twhunq/Butterfly-RC/design/drawings/rod_cut_list.md

# Danh sách cắt que carbon — mỗi cánh (nhân 2 cho cả bướm)

| Que | Vật liệu | Dài thiết kế (mm) | **Chiều dài cắt (mm)** | Tấm | Gắn vào | Góc với que gốc |
|---|---|---|---|---|---|---|
| LE | ống carbon 2.0×1.0 | 319.4 | **316.4** | trước | hub gốc cánh (gốc R) | — |
| Fold | que carbon đặc Ø1.0 | 280.7 | **277.7** | trước | hub gốc cánh (gốc R) | — |
| Root | que carbon đặc Ø1.0 | 253.2 | **250.2** | sau | hub gốc cánh (gốc R) | — |
| VeinA | que carbon đặc Ø1.0 | 257.5 | **255.5** | trước | khớp A trên que LE, cách R 70 mm | 34° |
| VeinB | que carbon đặc Ø0.8 | 210.4 | **208.4** | trước | khớp B trên que LE, cách R 170 mm | 17° |
| VeinC | que carbon đặc Ø0.8 | 271.5 | **270.0** | sau | khớp C trên que Fold, cách R 70 mm | 30° |
| VeinD | que carbon đặc Ø0.8 | 181.5 | **180.0** | sau | khớp D trên que Fold, cách R 170 mm | 23° |

- Chiều dài cắt = dài thiết kế trừ phần nằm trong lỗ khớp (hub gốc cánh: lỗ bắt đầu cách R 3 mm; khớp gân: cách mặt que gốc 1 mm).
- Màng mỗi bên: 844 cm² (tấm trước 470, tấm sau 374) + mép bọc 6 mm quanh que cạnh trước và que gốc.
- Gấp: phần sau gập xuống 6.62° quanh que gấp R–N → cánh sau cúi 5.0°, rủ thêm 4.3°.
- Xương sống: ống carbon tròn 3 × 2 mm, dài 154 mm (1 cây).
