twhunq/Butterfly-RC/design/drawings/wing_template_A2.pdf

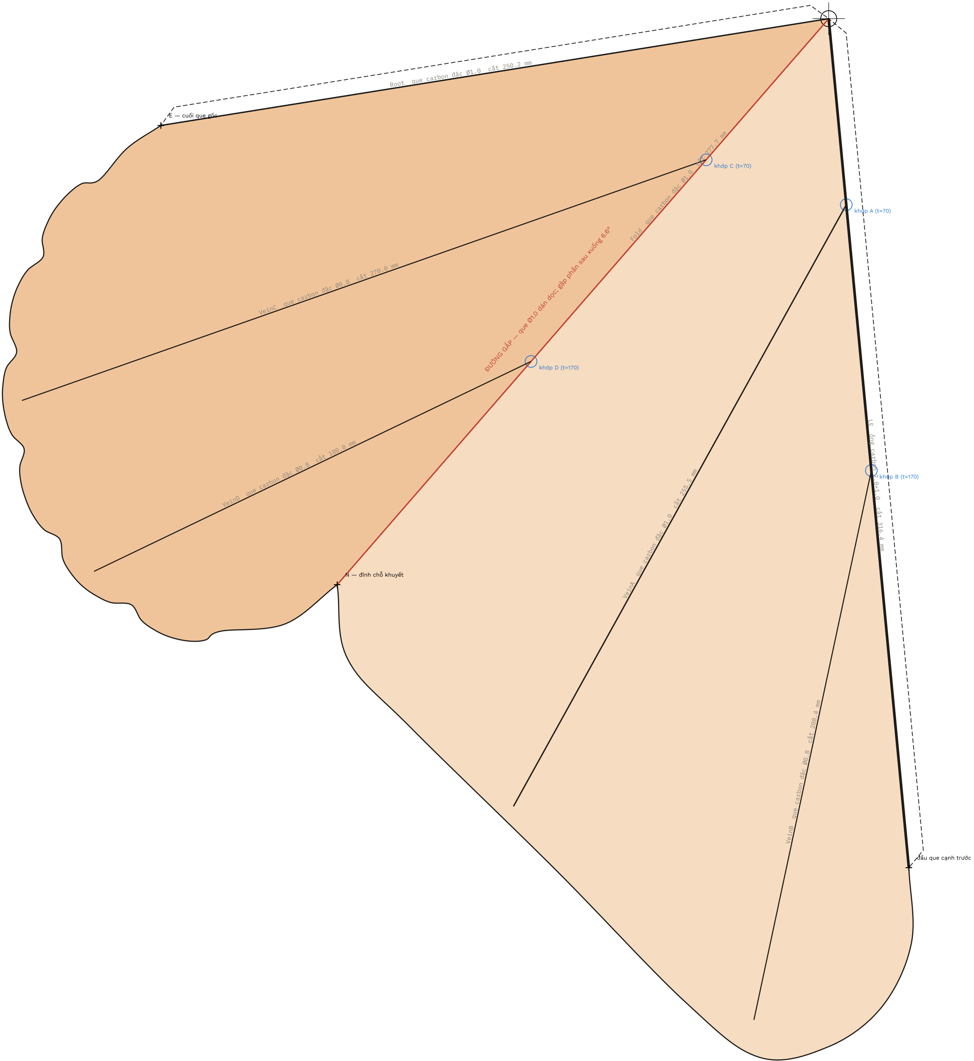
[picture p1: figure]
ĐƯỜNG GẤP; LE ống carbon 2.0×1.0 cắt 316.4 mm; Fold que carbon đặc Ø1.0 cắt 277.7 mm; Root que carbon đặc Ø1.0 cắt 250.2 mm; VeinA que carbon; đặc Ø1.0 cắt 255.5 mm; khớp A (t=70); VeinB que carbon; đặc Ø0.8 cắt 208.4 mm; khớp B (t=170); VeinC que carbon đặc Ø0.8 cắt 270.0 mm; khớp C (t=70); VeinD que carbon đặc Ø0.8 cắt 180.0 mm; khớp D (t=170); đầu que cạnh trước; N — đỉnh chỗ khuyết; E — cuối que gốc

## — que Ø1.0 dán dọc; gập phần sau xuống 6.6°

R — gốc cánh / tâm khớp nối tay servo

# CÁNH PHẢI — nhìn từ trên, mép trước bên phải, tỉ lệ 1:1

Thước kiểm tra: phải đo đúng 100 mm (và ô vuông 50 × 50 mm)

50 × 50 mm

### CẮT QUE CARBON (mỗi cánh; nhân 2 cho cả bướm)

Que | Vật liệu | Dài thiết kế | CHIỀU DÀI CẮT | Tấm | Gắn vào | Góc
LE | ống carbon 2.0×1.0 | 319.4 mm | 316.4 mm | trước | hub gốc cánh (gốc R) | —
Fold | que carbon đặc Ø1.0 | 280.7 mm | 277.7 mm | trước | hub gốc cánh (gốc R) | —
Root | que carbon đặc Ø1.0 | 253.2 mm | 250.2 mm | sau | hub gốc cánh (gốc R) | —
VeinA | que carbon đặc Ø1.0 | 257.5 mm | 255.5 mm | trước | khớp A trên que LE, cách R 70 mm | 34°
VeinB | que carbon đặc Ø0.8 | 210.4 mm | 208.4 mm | trước | khớp B trên que LE, cách R 170 mm | 17°
VeinC | que carbon đặc Ø0.8 | 271.5 mm | 270.0 mm | sau | khớp C trên que Fold, cách R 70 mm | 30°
VeinD | que carbon đặc Ø0.8 | 181.5 mm | 180.0 mm | sau | khớp D trên que Fold, cách R 170 mm | 23°

MÀNG: 1 tấm liền mỗi bên, 844 cm² (tấm trước 470 + tấm sau 374); chừa mép bọc 6 mm (nét đứt) quanh que cạnh trước và que gốc.

GẤP: dán que gấp Ø1.0 dọc đường gấp R–N; phần sau gập xuống 6.6° → cánh sau cúi 5°, rủ thêm 4.3°. Không dán que dọc mép sau (để màng tự xoắn).

Góc nhị diện 11° do khớp nối tay servo tạo sẵn. Dán màng hơi chùng; keo 3M Super 77 (mylar) hoặc B7000 (vải).

Kiểm tra trước khi cắt: thước 100 mm và ô 50 mm phải đúng kích thước sau khi in.

# BƯỚM RC · 2 SERVO · v3.1 — MẪU CẮT CÁNH

tỉ lệ 1 : 1 · in 100 % / Actual size

nguồn: butterfly_params.json · wing_geometry.py

tờ 1 / 2

2026-10-08 · mm

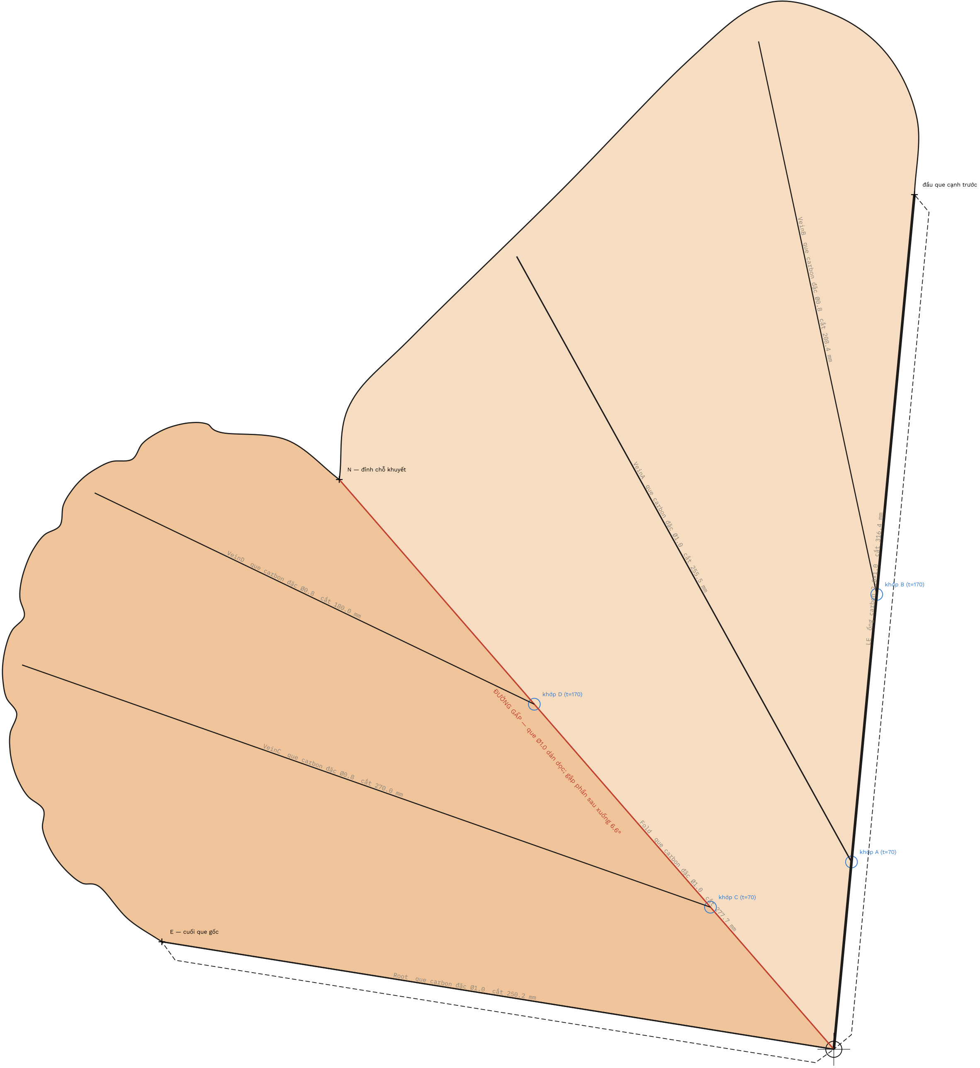
[picture p2: figure]
ĐƯỜNG GẤP; LE ống carbon 2.0×1.0 cắt 316.4 mm; Fold que carbon đặc Ø1.0 cắt 277.7 mm; Root que carbon đặc Ø1.0 cắt 250.2 mm; VeinA que carbon; đặc Ø1.0 cắt 255.5 mm; khớp A (t=70); VeinB que carbon; đặc Ø0.8 cắt 208.4 mm; khớp B (t=170); VeinC que carbon đặc Ø0.8 cắt 270.0 mm; khớp C (t=70); VeinD que carbon đặc Ø0.8 cắt 180.0 mm; khớp D (t=170); đầu que cạnh trước; N — đỉnh chỗ khuyết; E — cuối que gốc

## — que Ø1.0 dán dọc; gập phần sau xuống 6.6°

R — gốc cánh / tâm khớp nối tay servo

# CÁNH TRÁI — nhìn từ trên, mép trước bên phải, tỉ lệ 1:1

Thước kiểm tra: phải đo đúng 100 mm (và ô vuông 50 × 50 mm)

50 × 50 mm

### CẮT QUE CARBON (mỗi cánh; nhân 2 cho cả bướm)

Que | Vật liệu | Dài thiết kế | CHIỀU DÀI CẮT | Tấm | Gắn vào | Góc
LE | ống carbon 2.0×1.0 | 319.4 mm | 316.4 mm | trước | hub gốc cánh (gốc R) | —
Fold | que carbon đặc Ø1.0 | 280.7 mm | 277.7 mm | trước | hub gốc cánh (gốc R) | —
Root | que carbon đặc Ø1.0 | 253.2 mm | 250.2 mm | sau | hub gốc cánh (gốc R) | —
VeinA | que carbon đặc Ø1.0 | 257.5 mm | 255.5 mm | trước | khớp A trên que LE, cách R 70 mm | 34°
VeinB | que carbon đặc Ø0.8 | 210.4 mm | 208.4 mm | trước | khớp B trên que LE, cách R 170 mm | 17°
VeinC | que carbon đặc Ø0.8 | 271.5 mm | 270.0 mm | sau | khớp C trên que Fold, cách R 70 mm | 30°
VeinD | que carbon đặc Ø0.8 | 181.5 mm | 180.0 mm | sau | khớp D trên que Fold, cách R 170 mm | 23°

MÀNG: 1 tấm liền mỗi bên, 844 cm² (tấm trước 470 + tấm sau 374); chừa mép bọc 6 mm (nét đứt) quanh que cạnh trước và que gốc.

GẤP: dán que gấp Ø1.0 dọc đường gấp R–N; phần sau gập xuống 6.6° → cánh sau cúi 5°, rủ thêm 4.3°. Không dán que dọc mép sau (để màng tự xoắn).

Góc nhị diện 11° do khớp nối tay servo tạo sẵn. Dán màng hơi chùng; keo 3M Super 77 (mylar) hoặc B7000 (vải).

Kiểm tra trước khi cắt: thước 100 mm và ô 50 mm phải đúng kích thước sau khi in.

# BƯỚM RC · 2 SERVO · v3.1 — MẪU CẮT CÁNH

tỉ lệ 1 : 1 · in 100 % / Actual size

nguồn: butterfly_params.json · wing_geometry.py

tờ 2 / 2

2026-10-08 · mm
