twhunq/Butterfly-RC/design/drawings/butterfly_cover.png

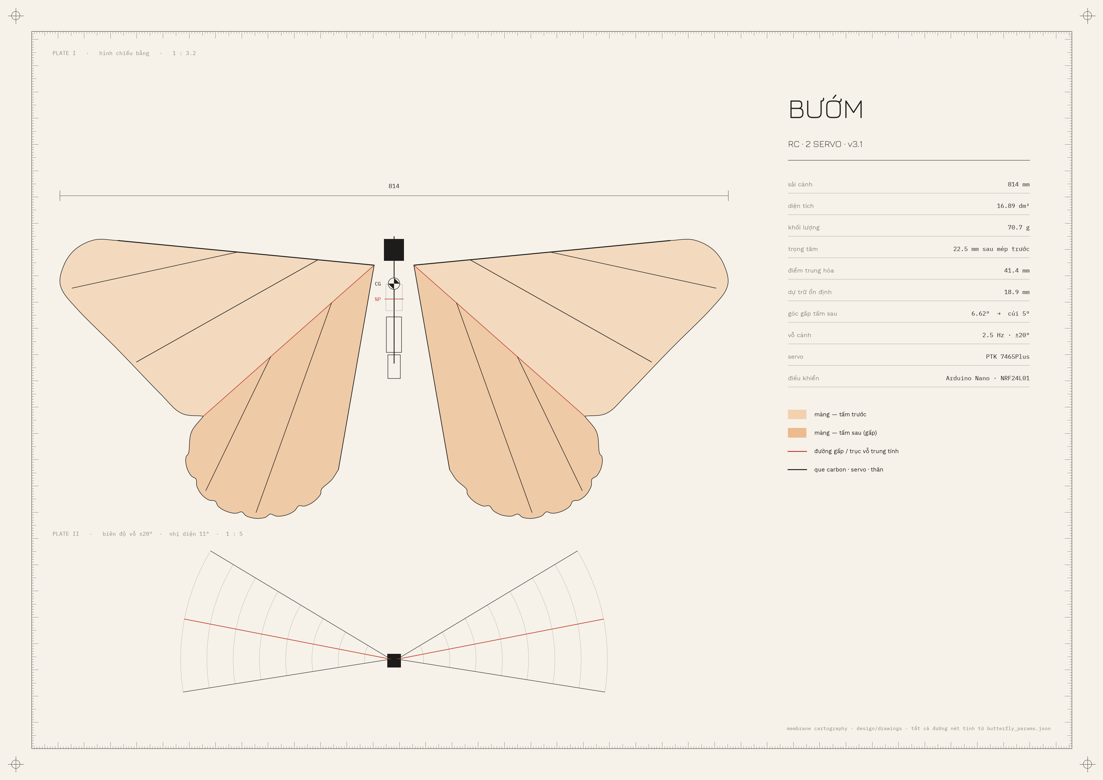
design/drawings/butterfly_cover.png
