twhunq/Butterfly-RC/simulation/front_turn.gif

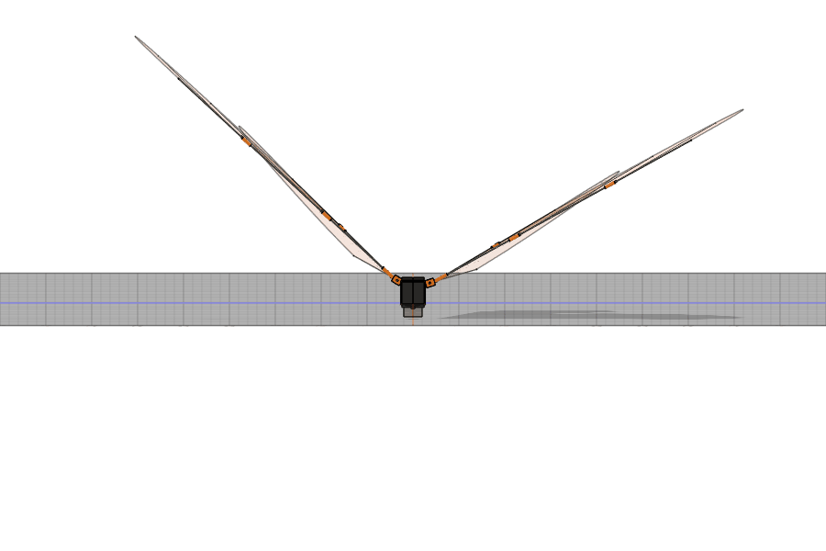
simulation/front_turn.gif
