twhunq/Butterfly-RC/simulation/iso_straight.gif

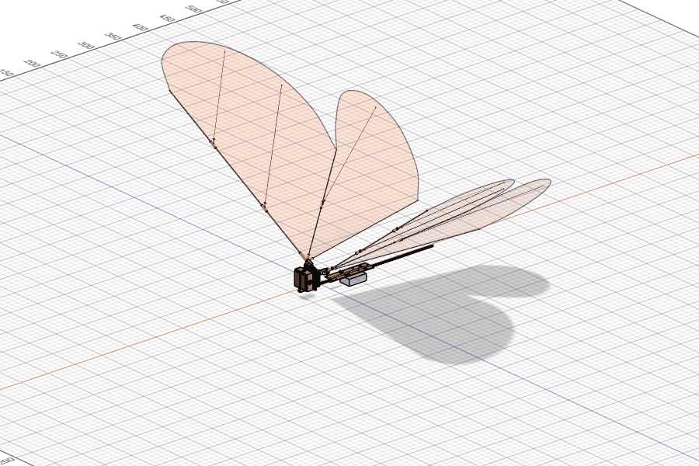
simulation/iso_straight.gif
