twhunq/Butterfly-RC/simulation/side_straight.gif

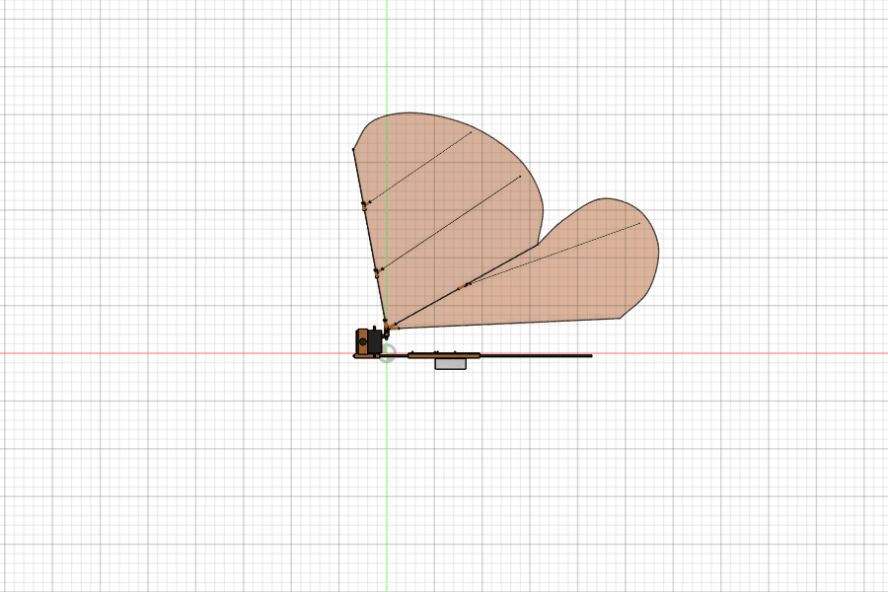
simulation/side_straight.gif
