twhunq/Butterfly-RC/simulation/top_straight.gif

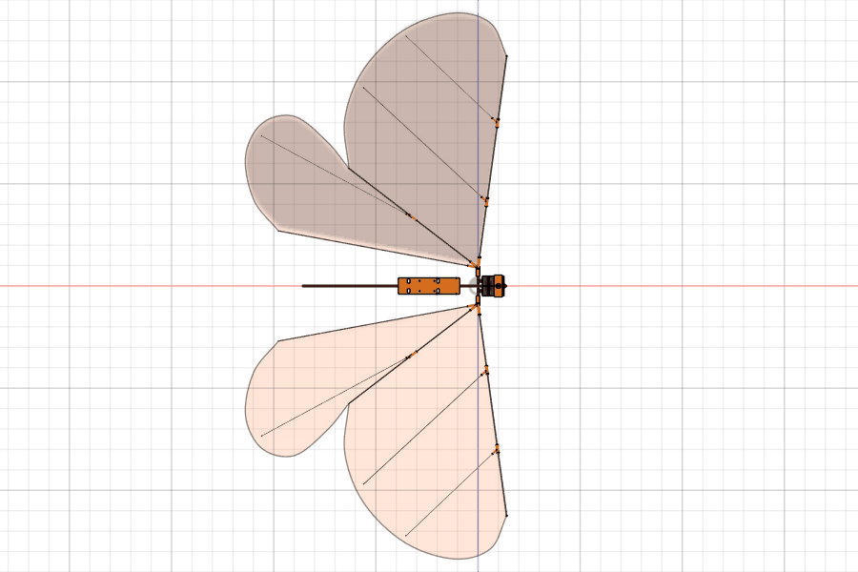
simulation/top_straight.gif
