twhunq/Butterfly-RC/simulation/v2_two_panels/top_straight.gif

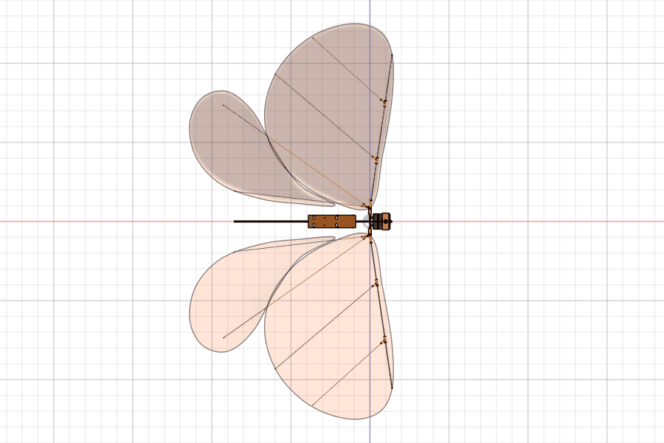
simulation/v2_two_panels/top_straight.gif
