twhunq/Butterfly-RC/design/cad/PTK_7465.step

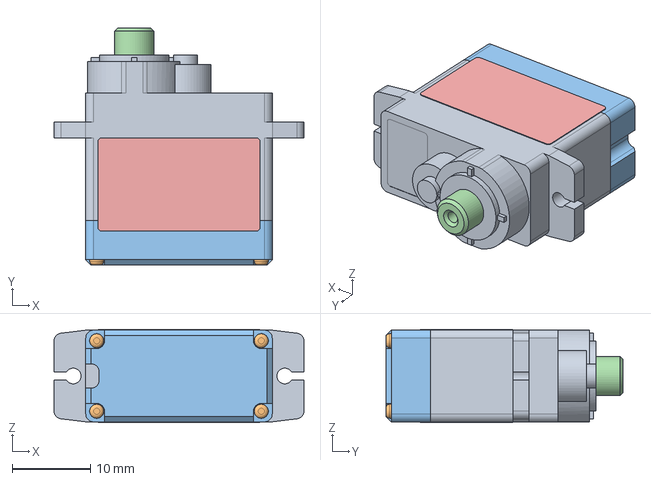
[picture p9: CAD file, 2026-10-11]
design/cad/PTK_7465.step
31.9 x 30.3 x 11.9 mm
