twhunq/Butterfly-RC/design/stl/PRINT_ConnD_R.stl

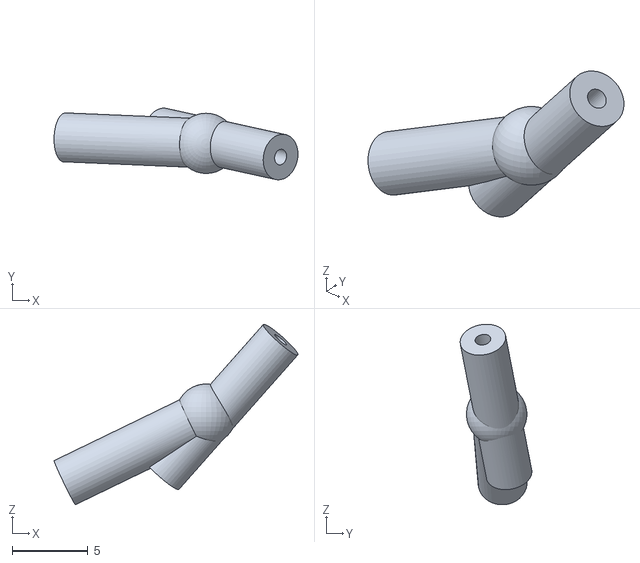
[picture p10: CAD file, 2026-10-11]
design/stl/PRINT_ConnD_R.stl
16.1 x 4.74 x 11.9
