twhunq/Butterfly-RC/design/stl/PRINT_ConnB_R.stl

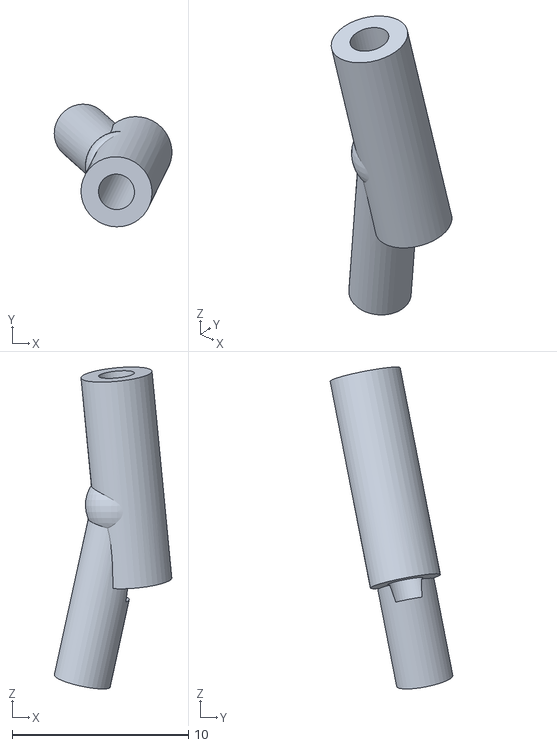
[picture p11: CAD file, 2026-10-11]
design/stl/PRINT_ConnB_R.stl
6.67 x 6.96 x 18.3
