twhunq/Butterfly-RC/design/stl/Frame_ServoMount.stl

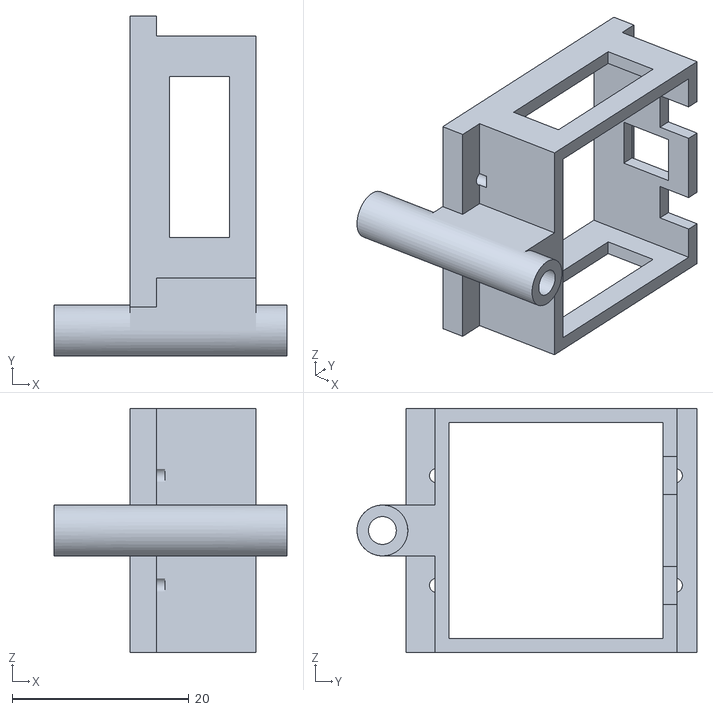
[picture p12: CAD file, 2026-10-11]
design/stl/Frame_ServoMount.stl
26.3 x 38.4 x 27.6
