twhunq/Butterfly-RC/design/stl/PRINT_AvionicsMount.stl

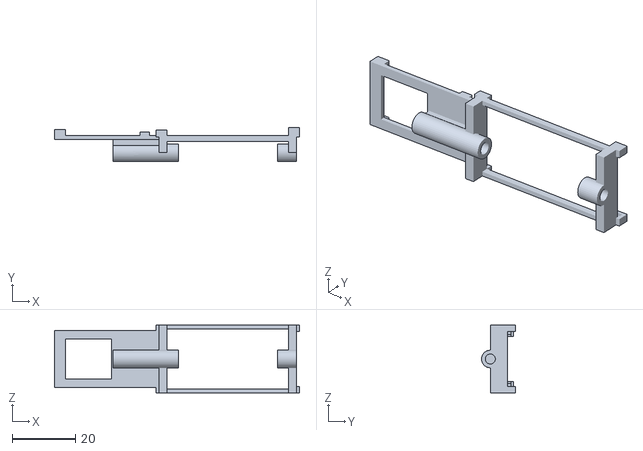
[picture p13: CAD file, 2026-10-11]
design/stl/PRINT_AvionicsMount.stl
77.2 x 10.7 x 21.3
