twhunq/Butterfly-RC/design/stl/PRINT_ConnA_L.stl

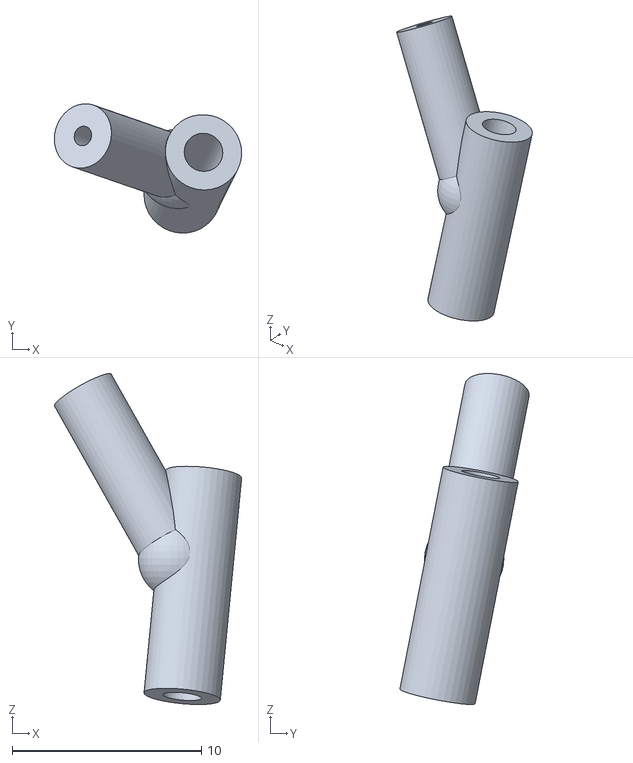
[picture p14: CAD file, 2026-10-11]
design/stl/PRINT_ConnA_L.stl
9.90 x 6.83 x 17.5
