twhunq/Butterfly-RC/design/stl/PRINT_ConnC_R.stl

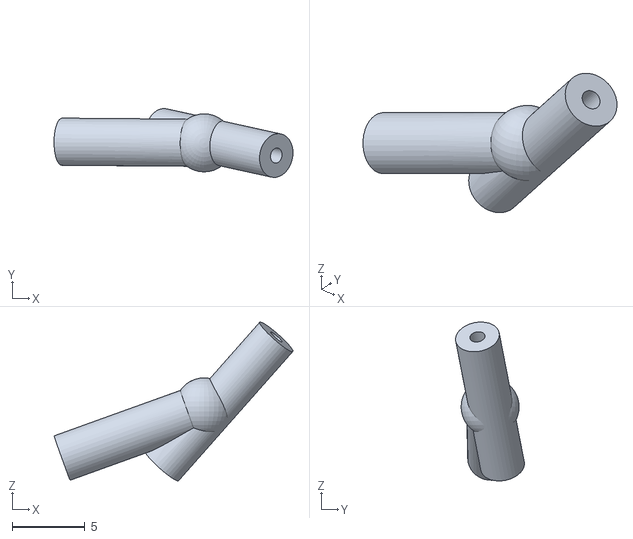
[picture p15: CAD file, 2026-10-11]
design/stl/PRINT_ConnC_R.stl
16.5 x 4.74 x 10.9
