twhunq/Butterfly-RC/design/stl/PRINT_WingHub_R.stl

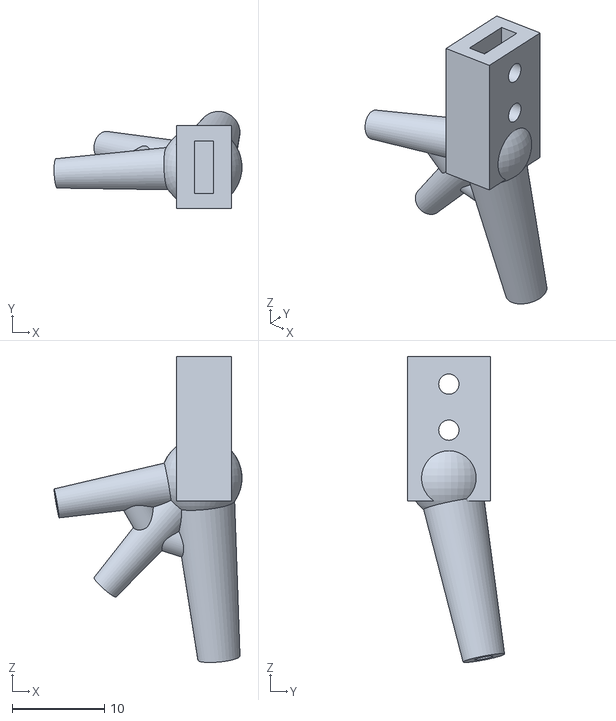
[picture p16: CAD file, 2026-10-11]
design/stl/PRINT_WingHub_R.stl
20.4 x 10.6 x 33.2
