twhunq/Butterfly-RC/design/stl/PRINT_BattMount.stl

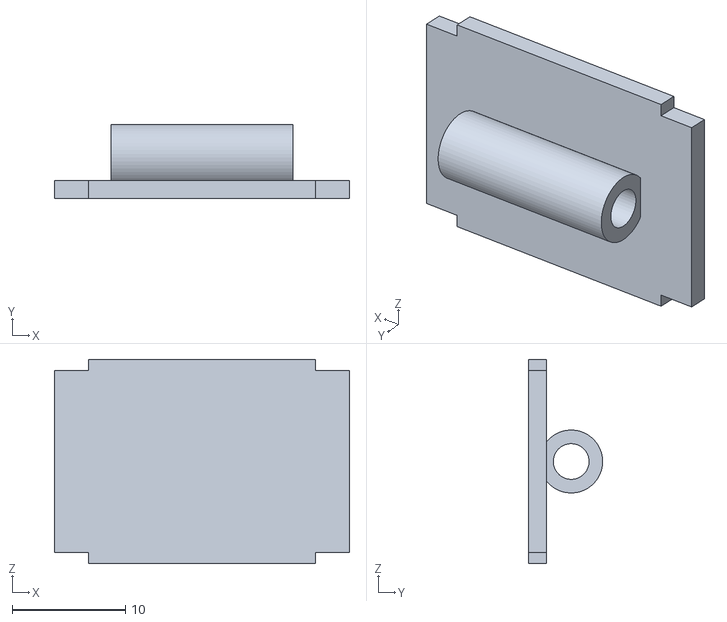
[picture p17: CAD file, 2026-10-11]
design/stl/PRINT_BattMount.stl
26.0 x 6.54 x 18.0
