twhunq/Butterfly-RC/(list of files, cad)

Other CAD files:
design/stl/PRINT_ConnD_L.stl
design/stl/PRINT_ConnB_L.stl
design/stl/PRINT_ConnC_L.stl
design/stl/PRINT_ConnA_R.stl
design/stl/PRINT_WingHub_L.stl
