twhunq/Butterfly-RC/analysis/results/freeflight/2w_cg15_h-4_U4.0_a9.csv

t_s | V_m_s | alpha_deg | beta_deg | yaw_deg | pitch_deg | roll_deg | x_m | y_m | z_m
0.00000 | 4.00000 | 9.00000 | 0.00000 | 0.00000 | 9.00000 | 0.00000 | 0.00000 | 0.00000 | 0.00000
0.01250 | 4.00000 | 9.00000 | -0.00000 | 0.00000 | 9.00000 | 0.00000 | 0.05000 | 0.00000 | 0.00000
0.02500 | 4.00000 | 9.00000 | -0.00000 | 0.00000 | 9.00000 | 0.00000 | 0.10000 | 0.00000 | 0.00000
0.03750 | 4.00000 | 9.00000 | -0.00000 | 0.00000 | 9.00000 | 0.00000 | 0.15000 | 0.00000 | 0.00000
0.05000 | 4.00000 | 9.00000 | -0.00000 | 0.00000 | 9.00000 | 0.00000 | 0.20000 | 0.00000 | 0.00000
0.06250 | 4.00000 | 9.00000 | -0.00000 | 0.00000 | 9.00000 | 0.00000 | 0.25000 | 0.00000 | 0.00000
0.07500 | 4.00000 | 9.00000 | -0.00000 | 0.00000 | 9.00000 | 0.00000 | 0.30000 | 0.00000 | 0.00000
0.08750 | 4.00000 | 9.00000 | -0.00000 | 0.00000 | 9.00000 | 0.00000 | 0.35000 | 0.00000 | 0.00000
0.10000 | 4.00000 | 9.00000 | -0.00000 | 0.00000 | 9.00000 | 0.00000 | 0.40000 | 0.00000 | 0.00000
0.11250 | 4.00000 | 9.00000 | -0.00000 | 0.00000 | 9.00000 | 0.00000 | 0.45000 | 0.00000 | 0.00000
0.12500 | 4.00000 | 9.00000 | -0.00000 | 0.00000 | 9.00000 | 0.00000 | 0.50000 | 0.00000 | 0.00000
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
