twhunq/Butterfly-RC/analysis/results/freeflight/2w_cg20_h-4_U3.6_a9.csv

t_s | V_m_s | alpha_deg | beta_deg | yaw_deg | pitch_deg | roll_deg | x_m | y_m | z_m
0.00000 | 3.60000 | 9.00000 | 0.00000 | 0.00000 | 9.00000 | 0.00000 | 0.00000 | 0.00000 | 0.00000
0.01250 | 3.60000 | 9.00000 | -0.00000 | 0.00000 | 9.00000 | 0.00000 | 0.04500 | 0.00000 | -0.00000
0.02500 | 3.60000 | 9.00000 | -0.00000 | 0.00000 | 9.00000 | 0.00000 | 0.09000 | 0.00000 | -0.00000
0.03750 | 3.60000 | 9.00000 | -0.00000 | 0.00000 | 9.00000 | 0.00000 | 0.13500 | 0.00000 | -0.00000
0.05000 | 3.60000 | 9.00000 | -0.00000 | 0.00000 | 9.00000 | 0.00000 | 0.18000 | 0.00000 | -0.00000
0.06250 | 3.60000 | 9.00000 | -0.00000 | 0.00000 | 9.00000 | 0.00000 | 0.22500 | 0.00000 | -0.00000
0.07500 | 3.60000 | 9.00000 | -0.00000 | 0.00000 | 9.00000 | 0.00000 | 0.27000 | 0.00000 | -0.00000
0.08750 | 3.60000 | 9.00000 | -0.00000 | 0.00000 | 9.00000 | 0.00000 | 0.31500 | 0.00000 | -0.00000
0.10000 | 3.60000 | 9.00000 | -0.00000 | 0.00000 | 9.00000 | 0.00000 | 0.36000 | 0.00000 | -0.00000
0.11250 | 3.60000 | 9.00000 | -0.00000 | 0.00000 | 9.00000 | 0.00000 | 0.40500 | 0.00000 | -0.00000
0.12500 | 3.60000 | 9.00000 | -0.00000 | 0.00000 | 9.00000 | 0.00000 | 0.45000 | 0.00000 | -0.00000
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
