twhunq/Butterfly-RC/analysis/results/freeflight/2w_cg20_h-6_U3.4_a12.csv

t_s | V_m_s | alpha_deg | beta_deg | yaw_deg | pitch_deg | roll_deg | x_m | y_m | z_m
0.00000 | 3.40000 | 12.00000 | 0.00000 | 0.00000 | 12.00000 | 0.00000 | 0.00000 | 0.00000 | 0.00000
0.01250 | 3.40000 | 12.00000 | -0.00000 | 0.00000 | 12.00000 | 0.00000 | 0.04250 | 0.00000 | 0.00000
0.02500 | 3.40000 | 12.00000 | -0.00000 | 0.00000 | 12.00000 | 0.00000 | 0.08500 | 0.00000 | 0.00000
0.03750 | 3.40000 | 12.00000 | -0.00000 | 0.00000 | 12.00000 | 0.00000 | 0.12750 | 0.00000 | 0.00000
0.05000 | 3.40000 | 12.00000 | -0.00000 | 0.00000 | 12.00000 | 0.00000 | 0.17000 | 0.00000 | 0.00000
0.06250 | 3.40000 | 12.00000 | -0.00000 | 0.00000 | 12.00000 | 0.00000 | 0.21250 | 0.00000 | 0.00000
0.07500 | 3.40000 | 12.00000 | -0.00000 | 0.00000 | 12.00000 | 0.00000 | 0.25500 | 0.00000 | 0.00000
0.08750 | 3.40000 | 12.00000 | -0.00000 | 0.00000 | 12.00000 | 0.00000 | 0.29750 | 0.00000 | 0.00000
0.10000 | 3.40000 | 12.00000 | -0.00000 | 0.00000 | 12.00000 | 0.00000 | 0.34000 | 0.00000 | 0.00000
0.11250 | 3.40000 | 12.00000 | -0.00000 | 0.00000 | 12.00000 | 0.00000 | 0.38250 | 0.00000 | 0.00000
0.12500 | 3.40000 | 12.00000 | -0.00000 | 0.00000 | 12.00000 | 0.00000 | 0.42500 | 0.00000 | 0.00000
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
