twhunq/Butterfly-RC/analysis/results/freeflight/cg20_f2.2_a30_U3.6.csv

t_s | V_m_s | alpha_deg | beta_deg | yaw_deg | pitch_deg | roll_deg | x_m | y_m | z_m
0.00000 | 3.60000 | 9.00000 | 0.00000 | 0.00000 | 9.00000 | 0.00000 | 0.00000 | 0.00000 | 0.00000
0.01420 | 3.60000 | 9.00000 | -0.00000 | 0.00000 | 9.00000 | 0.00000 | 0.05114 | 0.00000 | -0.00000
0.02841 | 3.60000 | 9.00000 | -0.00000 | 0.00000 | 9.00000 | 0.00000 | 0.10227 | 0.00000 | -0.00000
0.04261 | 3.60000 | 9.00000 | -0.00000 | 0.00000 | 9.00000 | 0.00000 | 0.15341 | 0.00000 | -0.00000
0.05682 | 3.60000 | 9.00000 | -0.00000 | 0.00000 | 9.00000 | 0.00000 | 0.20455 | 0.00000 | -0.00000
0.07102 | 3.60000 | 9.00000 | -0.00000 | 0.00000 | 9.00000 | 0.00000 | 0.25568 | 0.00000 | -0.00000
0.08523 | 3.60000 | 9.00000 | -0.00000 | 0.00000 | 9.00000 | 0.00000 | 0.30682 | 0.00000 | -0.00000
0.09943 | 3.60000 | 9.00000 | -0.00000 | 0.00000 | 9.00000 | 0.00000 | 0.35795 | 0.00000 | -0.00000
0.11364 | 3.60000 | 9.00000 | -0.00000 | 0.00000 | 9.00000 | 0.00000 | 0.40909 | 0.00000 | -0.00000
0.12784 | 3.60000 | 9.00000 | -0.00000 | 0.00000 | 9.00000 | 0.00000 | 0.46023 | 0.00000 | -0.00000
0.14205 | 3.60000 | 9.00000 | -0.00000 | 0.00000 | 9.00000 | 0.00000 | 0.51136 | 0.00000 | -0.00000
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
