twhunq/Butterfly-RC/analysis/results/freeflight/cg20_f2.5_a20_U3.8.csv

t_s | V_m_s | alpha_deg | beta_deg | yaw_deg | pitch_deg | roll_deg | x_m | y_m | z_m
0.00000 | 3.80000 | 9.00000 | 0.00000 | 0.00000 | 9.00000 | 0.00000 | 0.00000 | 0.00000 | 0.00000
0.01250 | 3.80000 | 9.00000 | -0.00000 | 0.00000 | 9.00000 | 0.00000 | 0.04750 | 0.00000 | 0.00000
0.02500 | 3.80000 | 9.00000 | -0.00000 | 0.00000 | 9.00000 | 0.00000 | 0.09500 | 0.00000 | 0.00000
0.03750 | 3.80000 | 9.00000 | -0.00000 | 0.00000 | 9.00000 | 0.00000 | 0.14250 | 0.00000 | 0.00000
0.05000 | 3.80000 | 9.00000 | -0.00000 | 0.00000 | 9.00000 | 0.00000 | 0.19000 | 0.00000 | 0.00000
0.06250 | 3.80000 | 9.00000 | -0.00000 | 0.00000 | 9.00000 | 0.00000 | 0.23750 | 0.00000 | 0.00000
0.07500 | 3.80000 | 9.00000 | -0.00000 | 0.00000 | 9.00000 | 0.00000 | 0.28500 | 0.00000 | 0.00000
0.08750 | 3.80000 | 9.00000 | -0.00000 | 0.00000 | 9.00000 | 0.00000 | 0.33250 | 0.00000 | 0.00000
0.10000 | 3.80000 | 9.00000 | -0.00000 | 0.00000 | 9.00000 | 0.00000 | 0.38000 | 0.00000 | 0.00000
0.11250 | 3.80000 | 9.00000 | -0.00000 | 0.00000 | 9.00000 | 0.00000 | 0.42750 | 0.00000 | 0.00000
0.12500 | 3.80000 | 9.00000 | -0.00000 | 0.00000 | 9.00000 | 0.00000 | 0.47500 | 0.00000 | 0.00000
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
