twhunq/Butterfly-RC/analysis/results/aero_structure.png

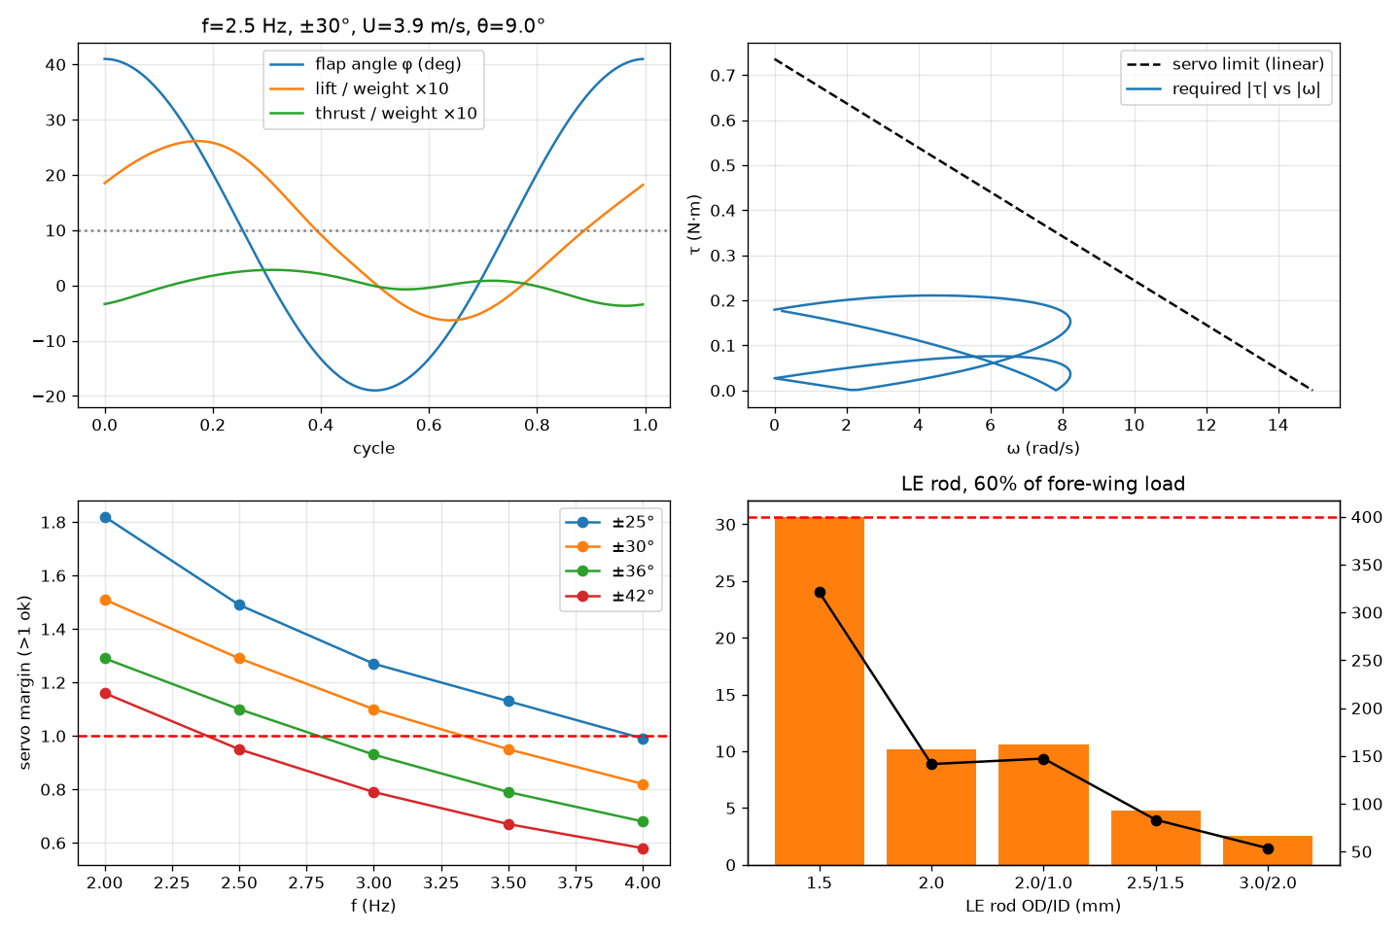
analysis/results/aero_structure.png
