twhunq/Butterfly-RC/analysis/results/freeflight_compare.png

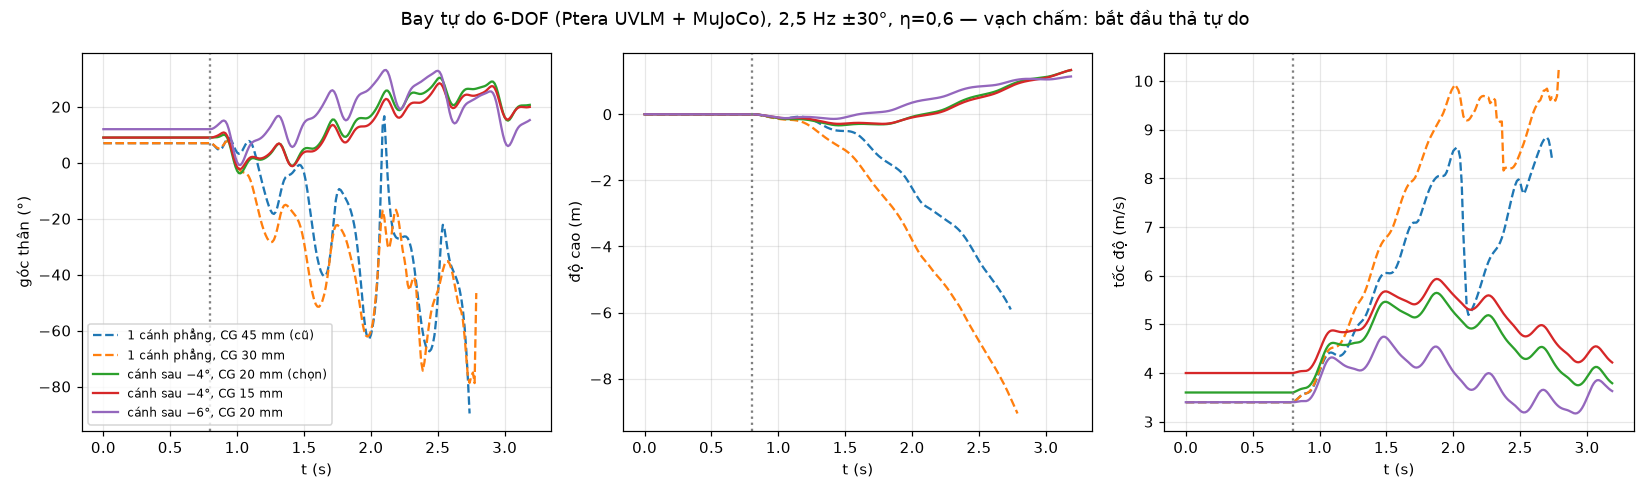
analysis/results/freeflight_compare.png
