twhunq/Butterfly-RC/analysis/results/freeflight_v2.png

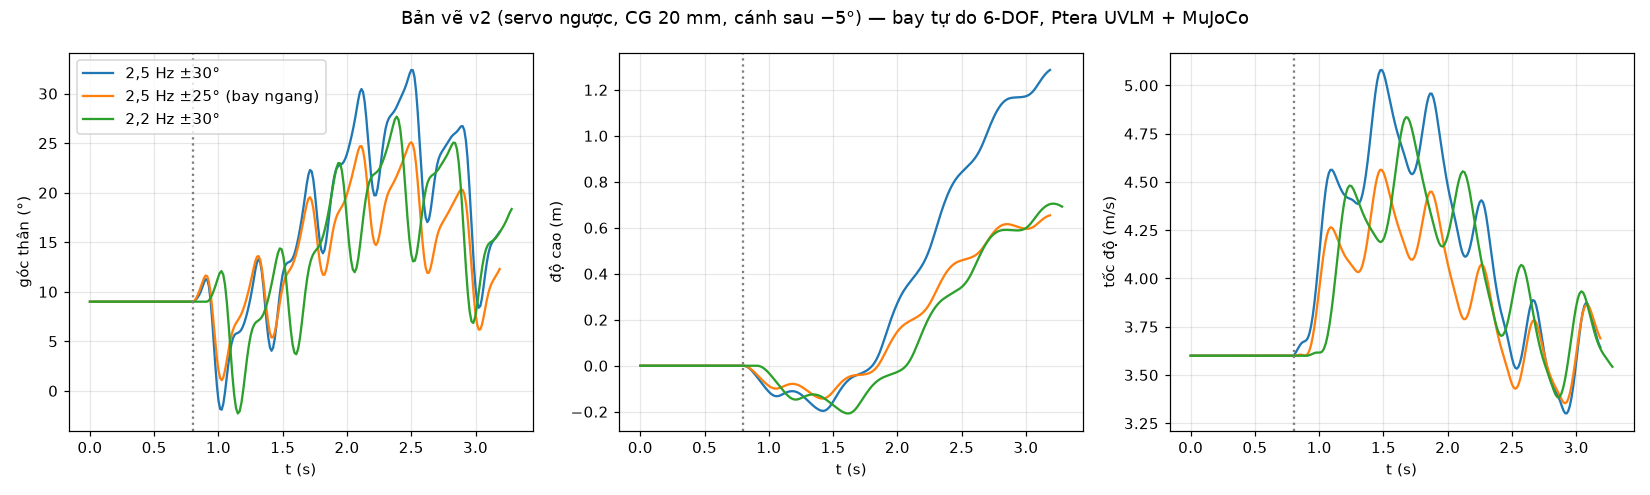
analysis/results/freeflight_v2.png
