twhunq/Butterfly-RC/analysis/results/freeflight_v3.png

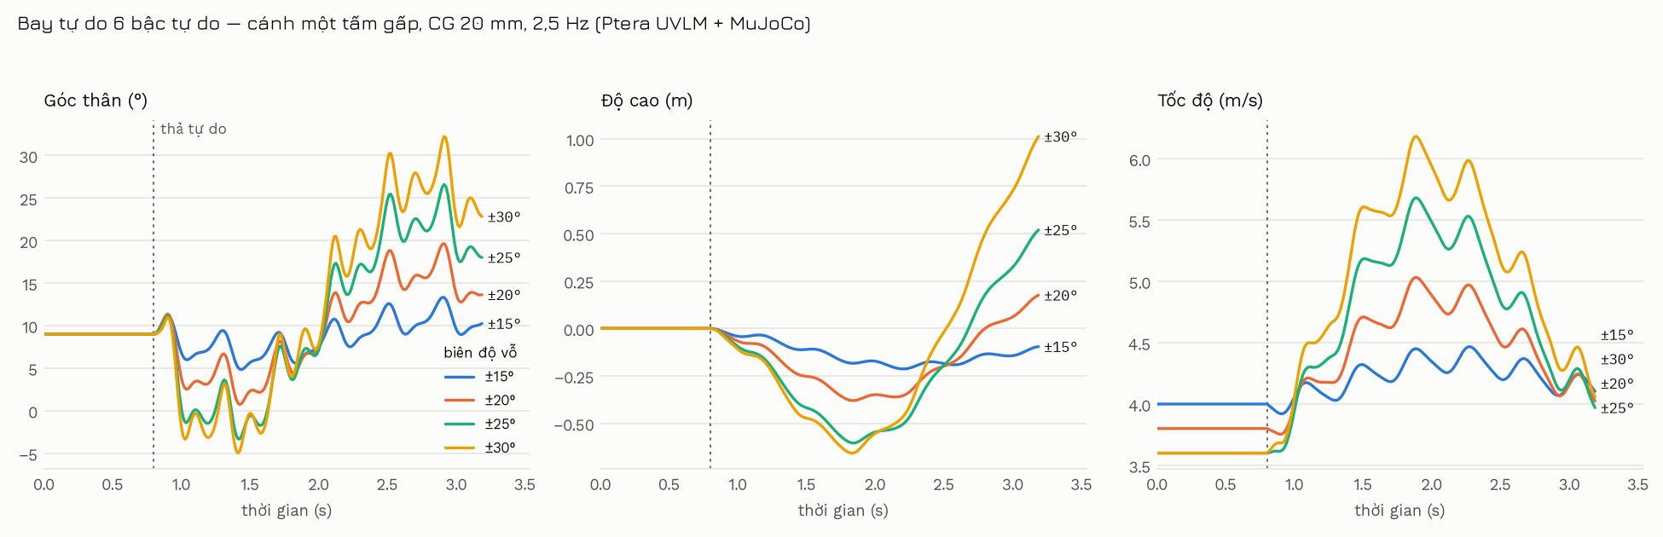
analysis/results/freeflight_v3.png
