twhunq/Butterfly-RC/analysis/results/lobes.png

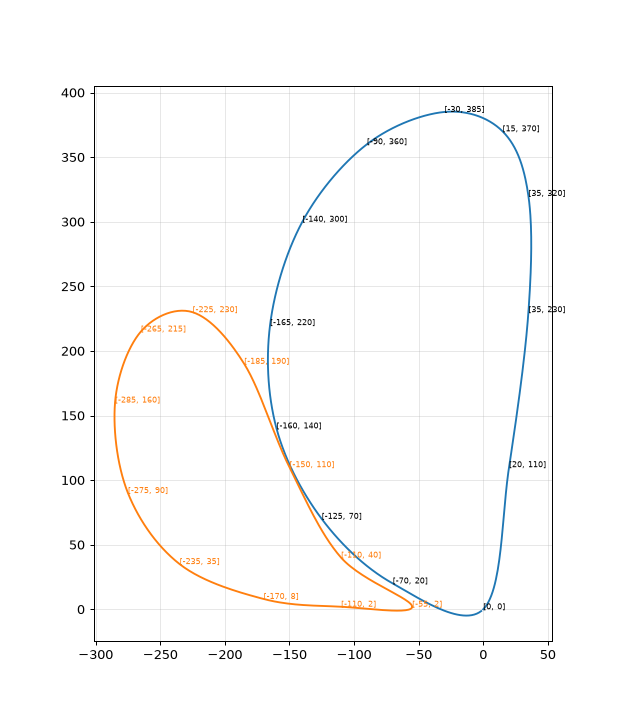
analysis/results/lobes.png
