twhunq/Butterfly-RC/analysis/results/freeflight/cg30_eta06_history.png

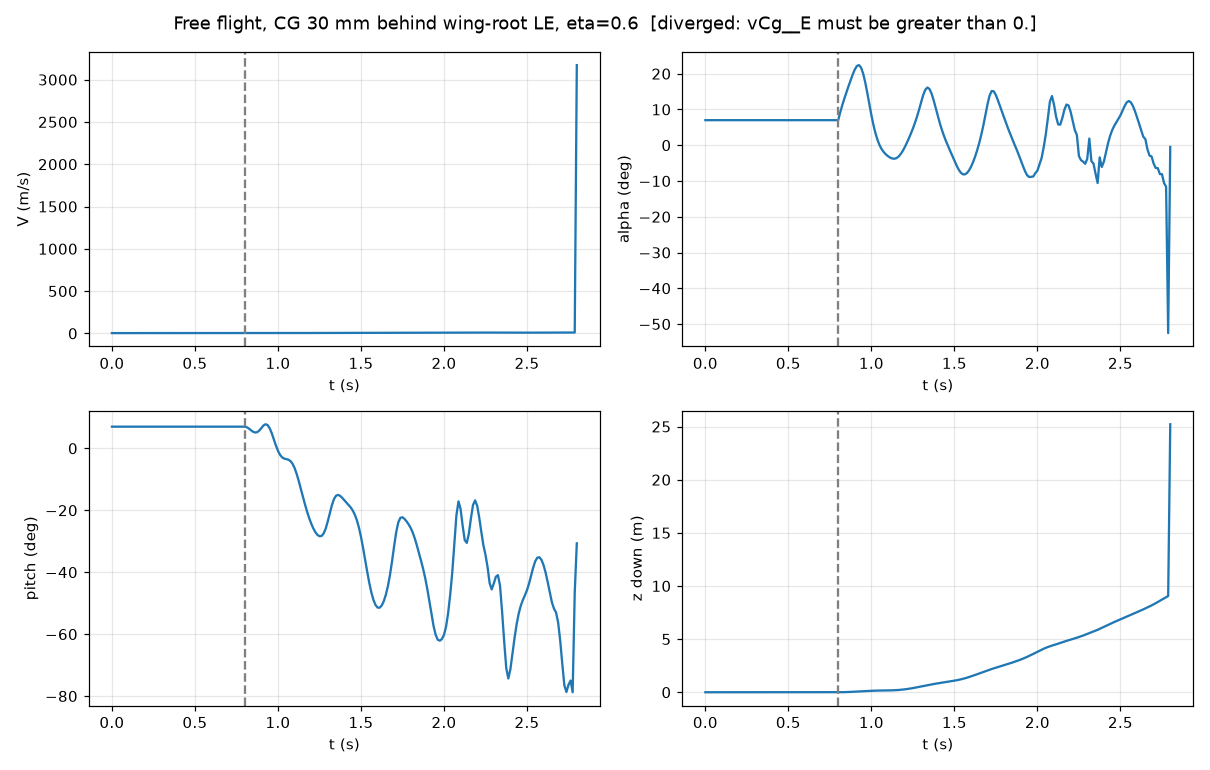
analysis/results/freeflight/cg30_eta06_history.png
