twhunq/Butterfly-RC/analysis/results/freeflight/cg45_eta06_history.png

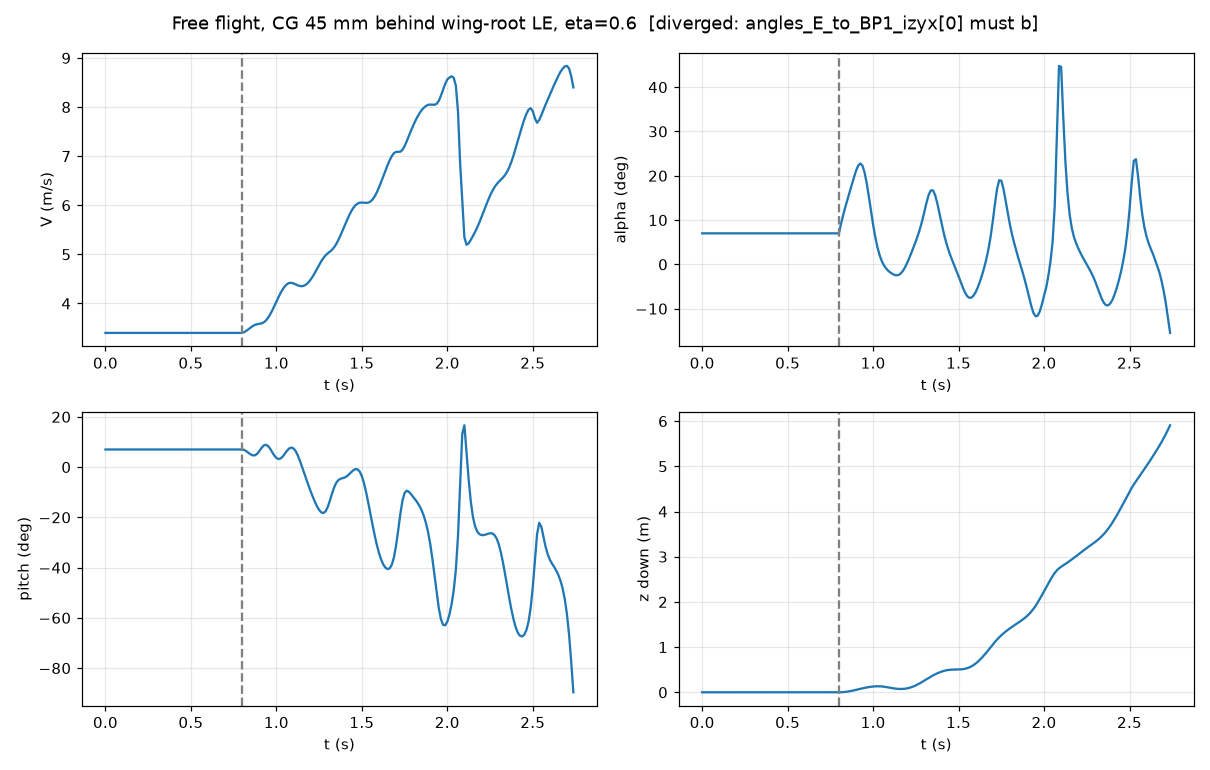
analysis/results/freeflight/cg45_eta06_history.png
