twhunq/Butterfly-RC/design/drawings/butterfly_cover.pdf

# BƯỚM

## RC · 2 SERVO · v3.1

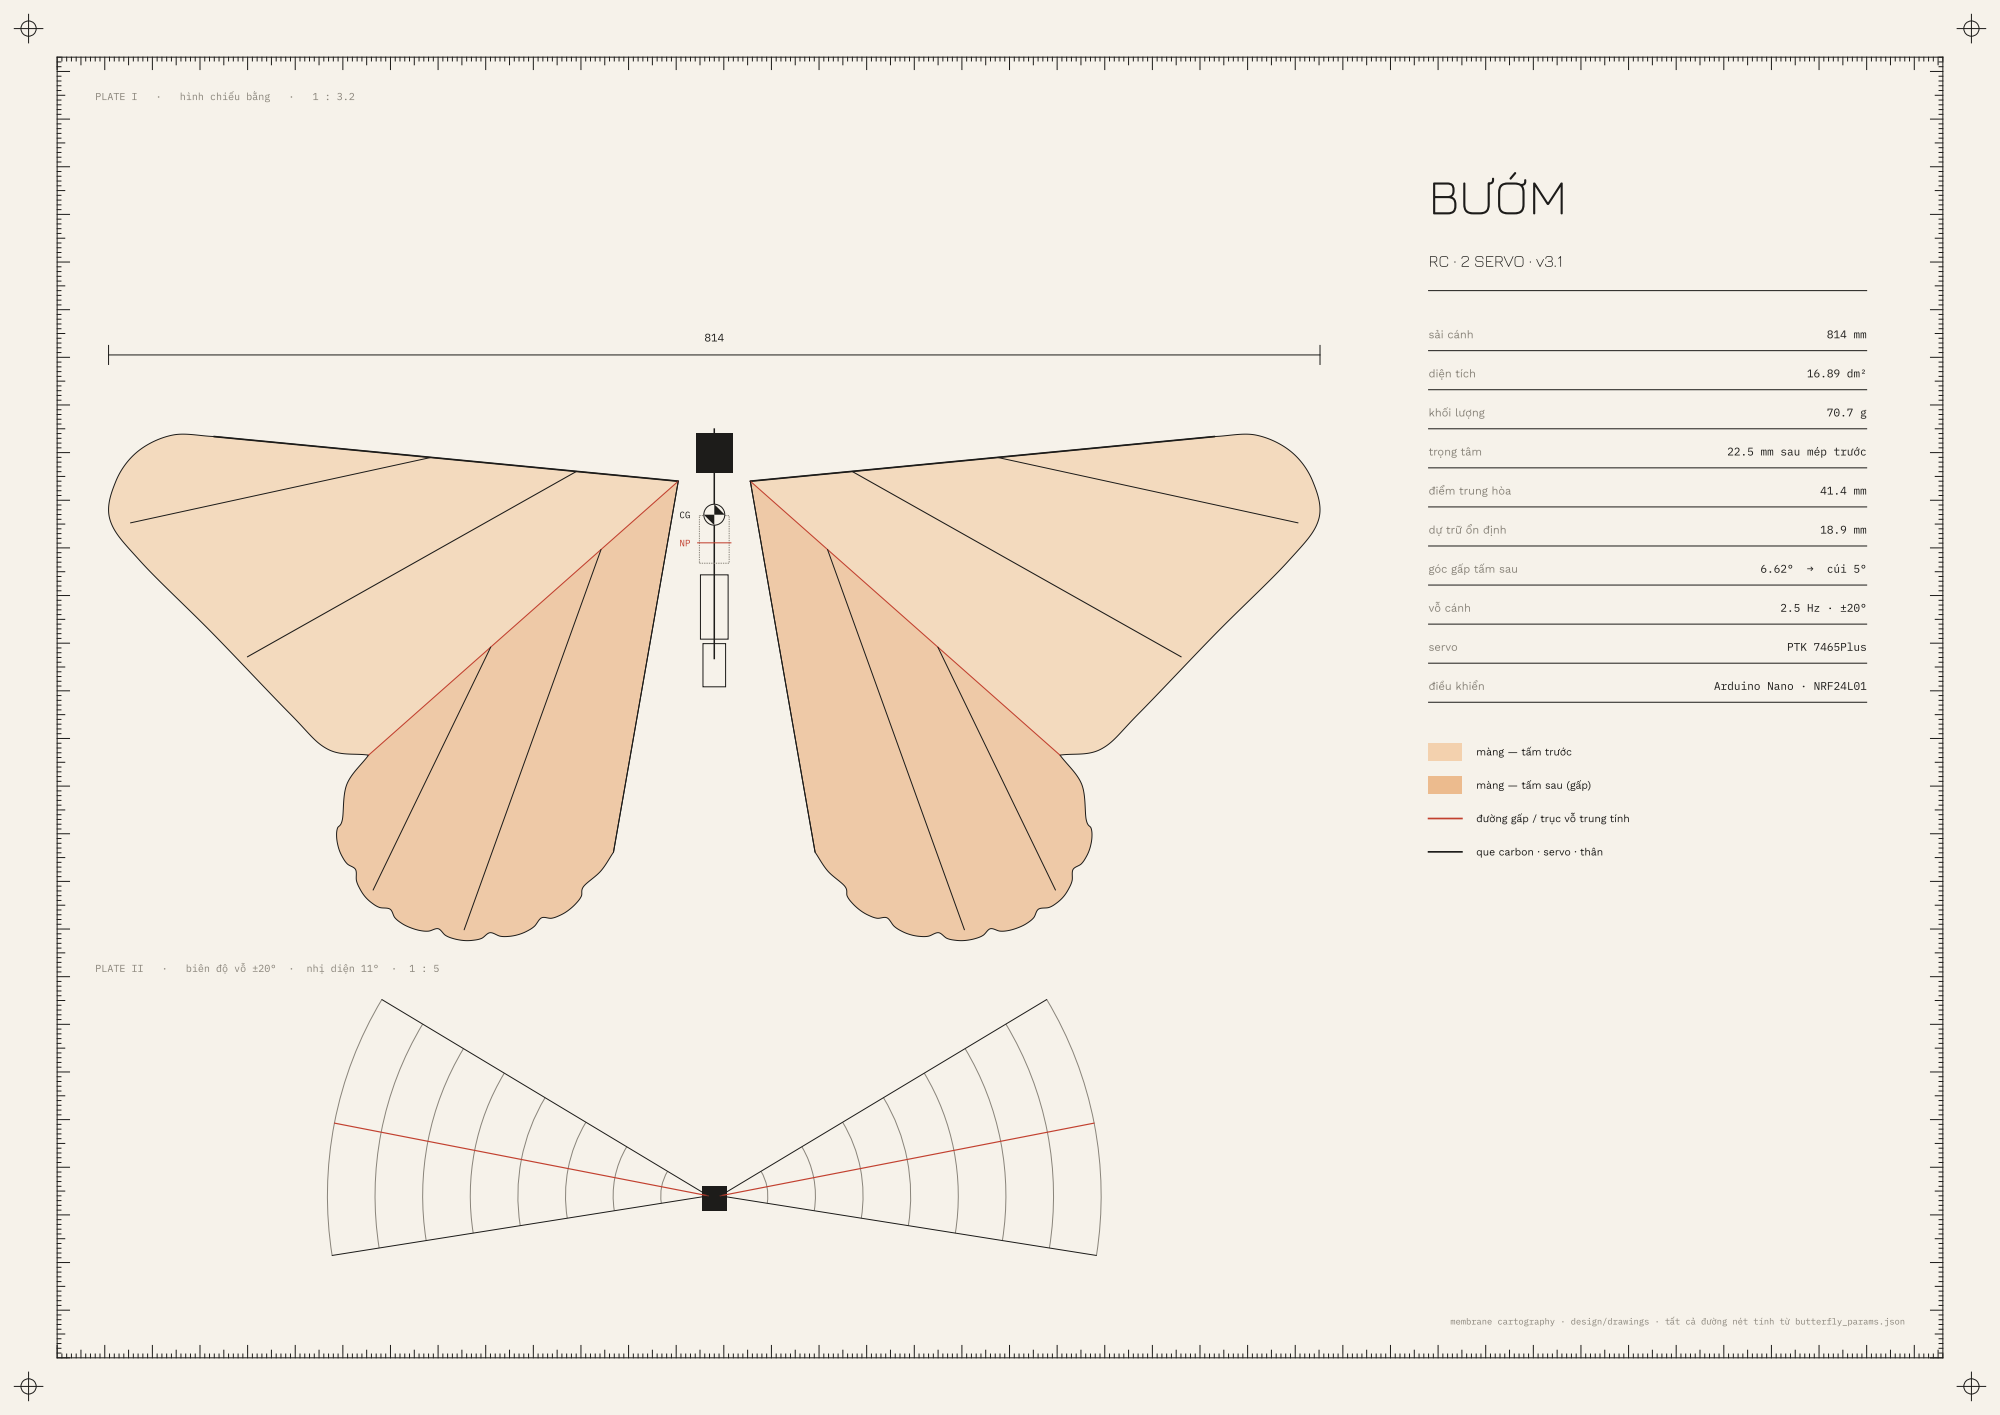
[picture p25: page 1]
PLATE I; hình chiếu bằng; PLATE II; biên độ vỗ ±20°; nhị diện 11°; sải cánh; diện tích; 16.89 dm²; khối lượng; trọng tâm; 22.5 mm sau mép trước; điểm trung hòa; dự trữ ổn định; góc gấp tấm sau; → cúi 5°; vỗ cánh; servo; PTK 7465Plus; điều khiển; Arduino Nano · NRF24L01

màng — tấm trước

màng — tấm sau (gấp)

đường gấp / trục vỗ trung tính

que carbon · servo · thân

membrane cartography · design/drawings · tất cả đường nét tính từ butterfly_params.json
