twhunq/Butterfly-RC/design/drawings/wing_template_A4_tiles.pdf

# CÁNH PHẢI — nhìn từ trên, mép trước bên phải, tỉ lệ 1:1

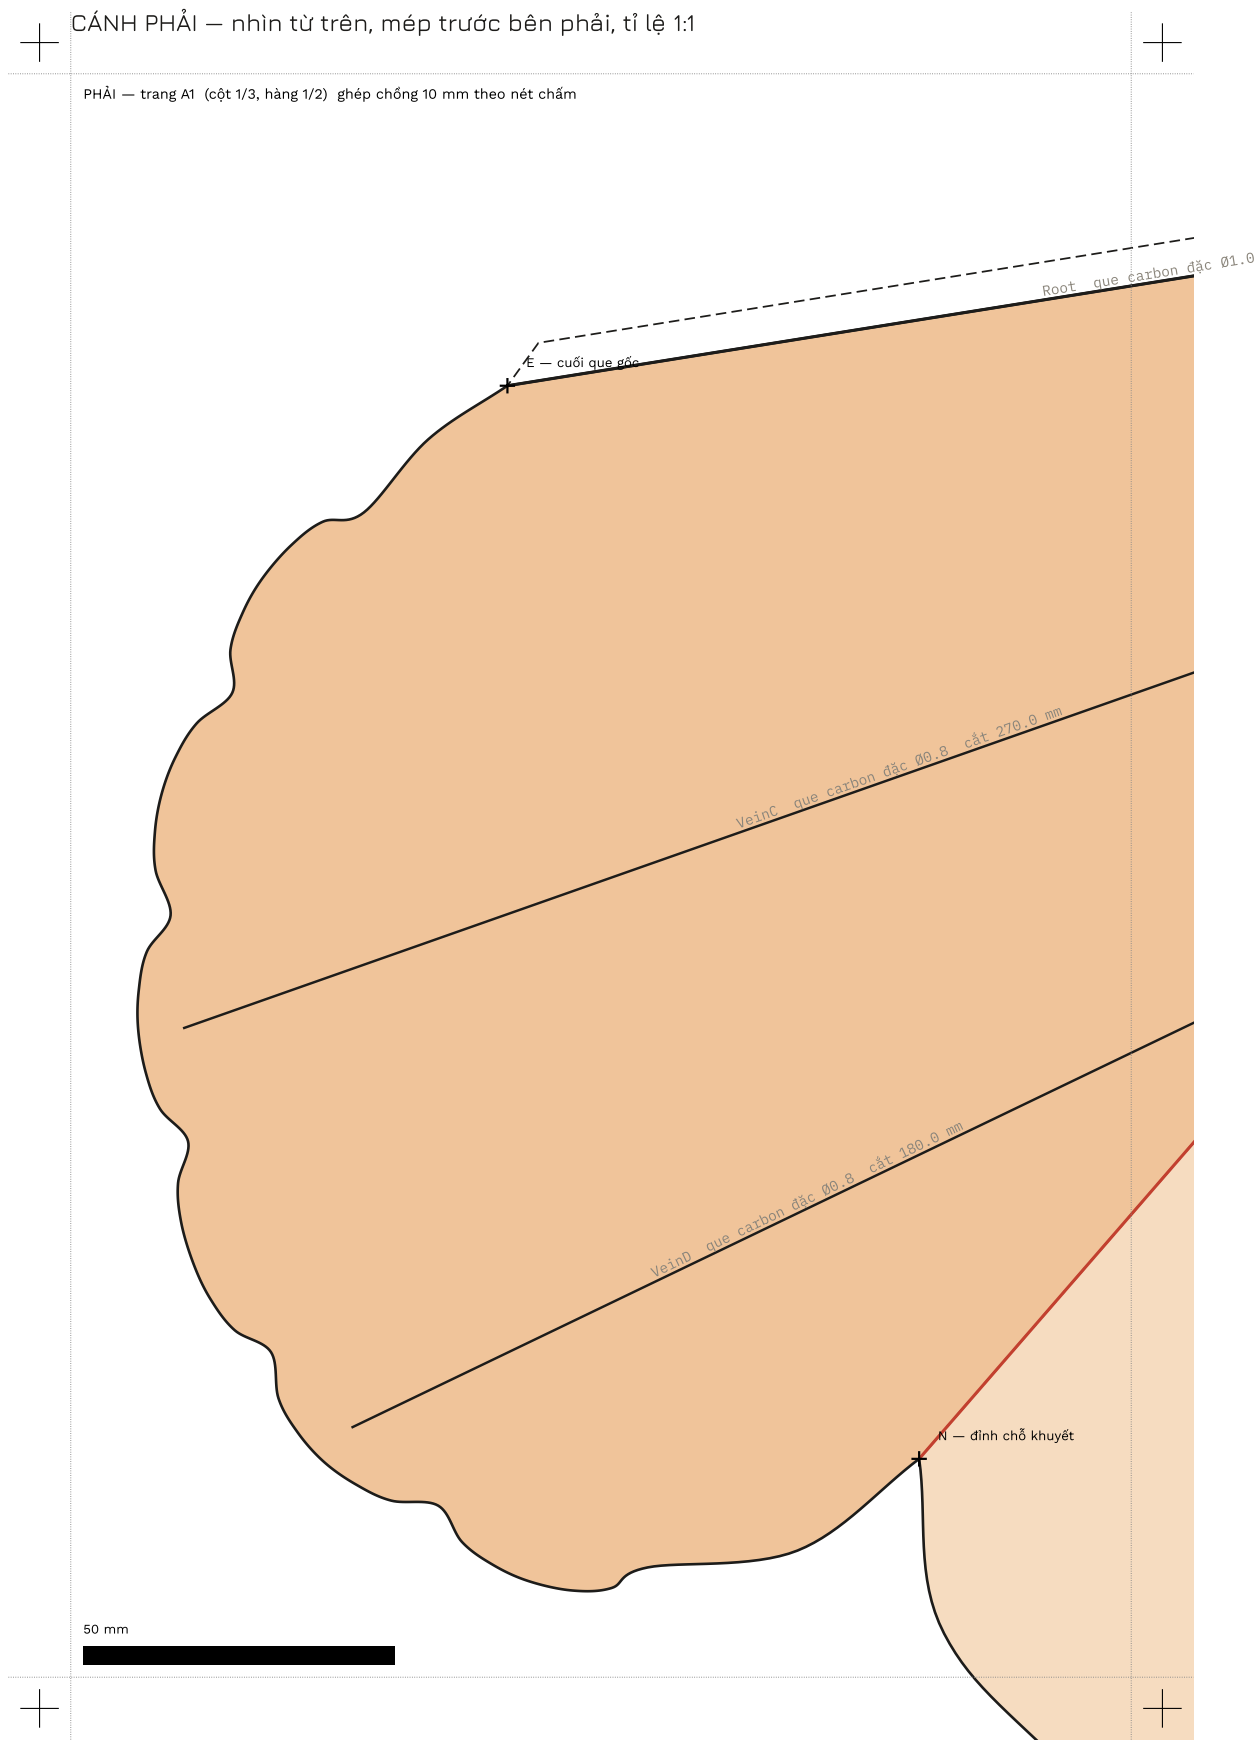
[picture p26: page 1]

PHẢI — trang A1 (cột 1/3, hàng 1/2) ghép chồng 10 mm theo nét chấm

Root que carbon đặc Ø1.0 cắt 250.2 mm

E — cuối que gốc

VeinC que carbon đặc Ø0.8 cắt 270.0 mm

VeinD que carbon đặc Ø0.8 cắt 180.0 mm

N — đỉnh chỗ khuyết

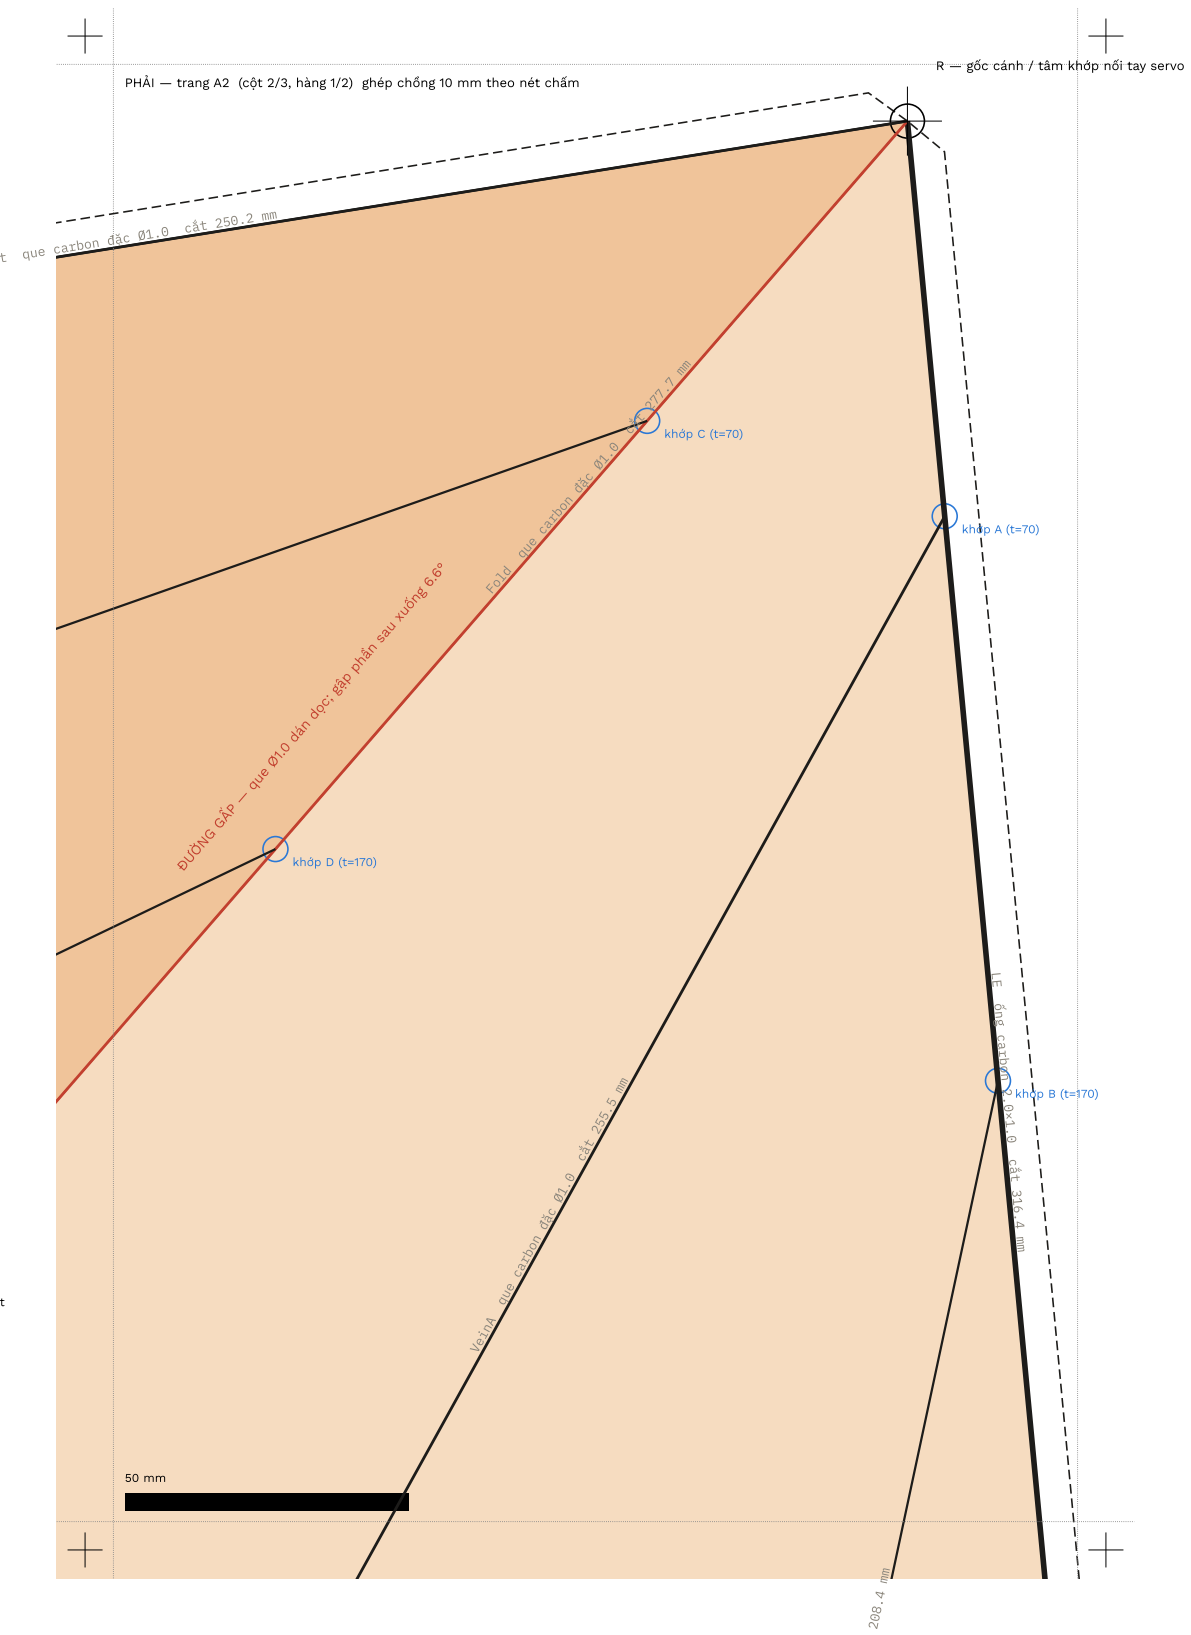
[picture p27: page 2]
ĐƯỜNG GẤP; khớp A (t=70); khớp B (t=170); khớp C (t=70); khớp D (t=170)

R — gốc cánh / tâm khớp nối tay servo

PHẢI — trang A2 (cột 2/3, hàng 1/2) ghép chồng 10 mm theo nét chấm

Root que carbon đặc Ø1.0 cắt 250.2 mm

Fold que carbon đặc Ø1.0 cắt 277.7 mm

— que Ø1.0 dán dọc; gập phần sau xuống 6.6°

LE ống carbon 2.0×1.0 cắt 316.4 mm

đặc Ø1.0 cắt 255.5 mm

VeinA que carbon

N — đỉnh chỗ khuyết

đặc Ø0.8 cắt 208.4 mm

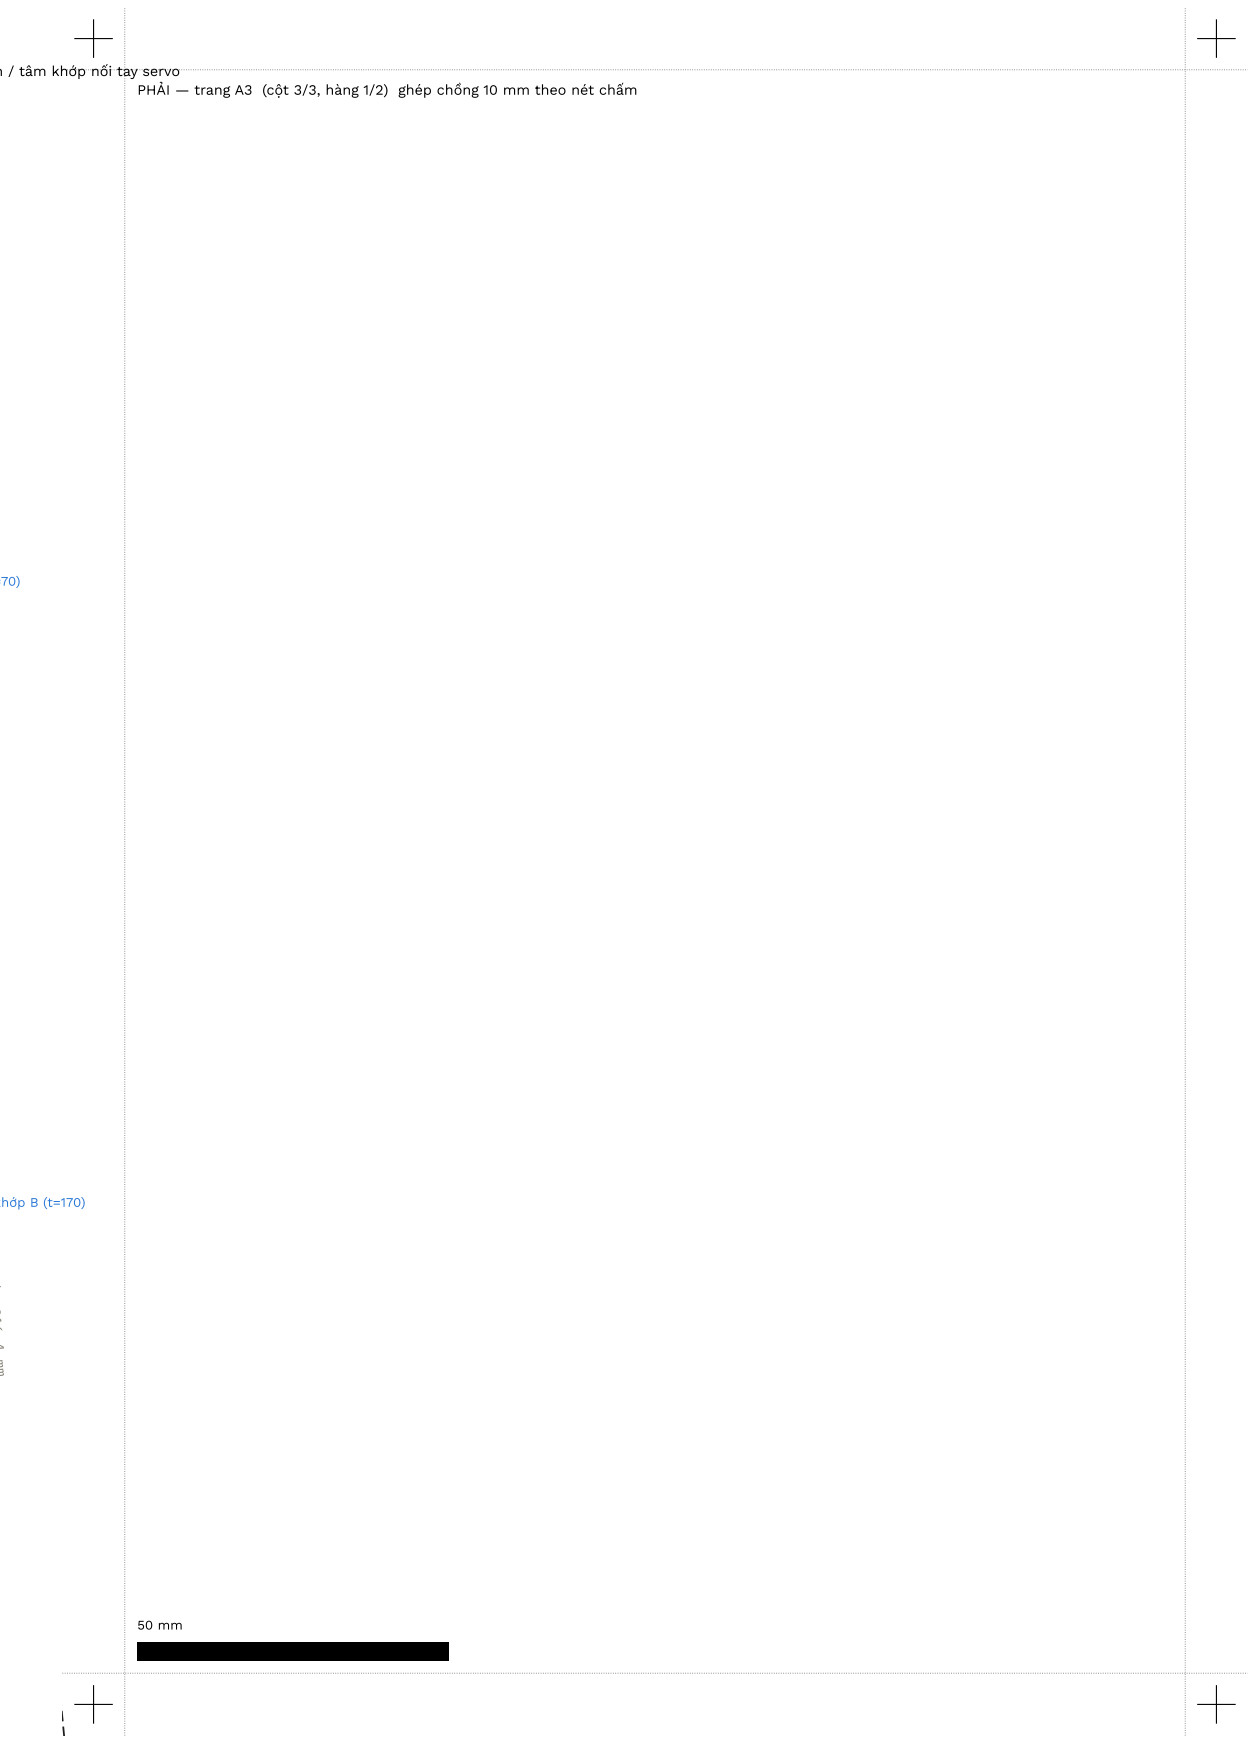
[picture p28: page 3]
khớp A (t=70); khớp B (t=170)

R — gốc cánh / tâm khớp nối tay servo

PHẢI — trang A3 (cột 3/3, hàng 1/2) ghép chồng 10 mm theo nét chấm

LE ống carbon 2.0×1.0 cắt 316.4 mm

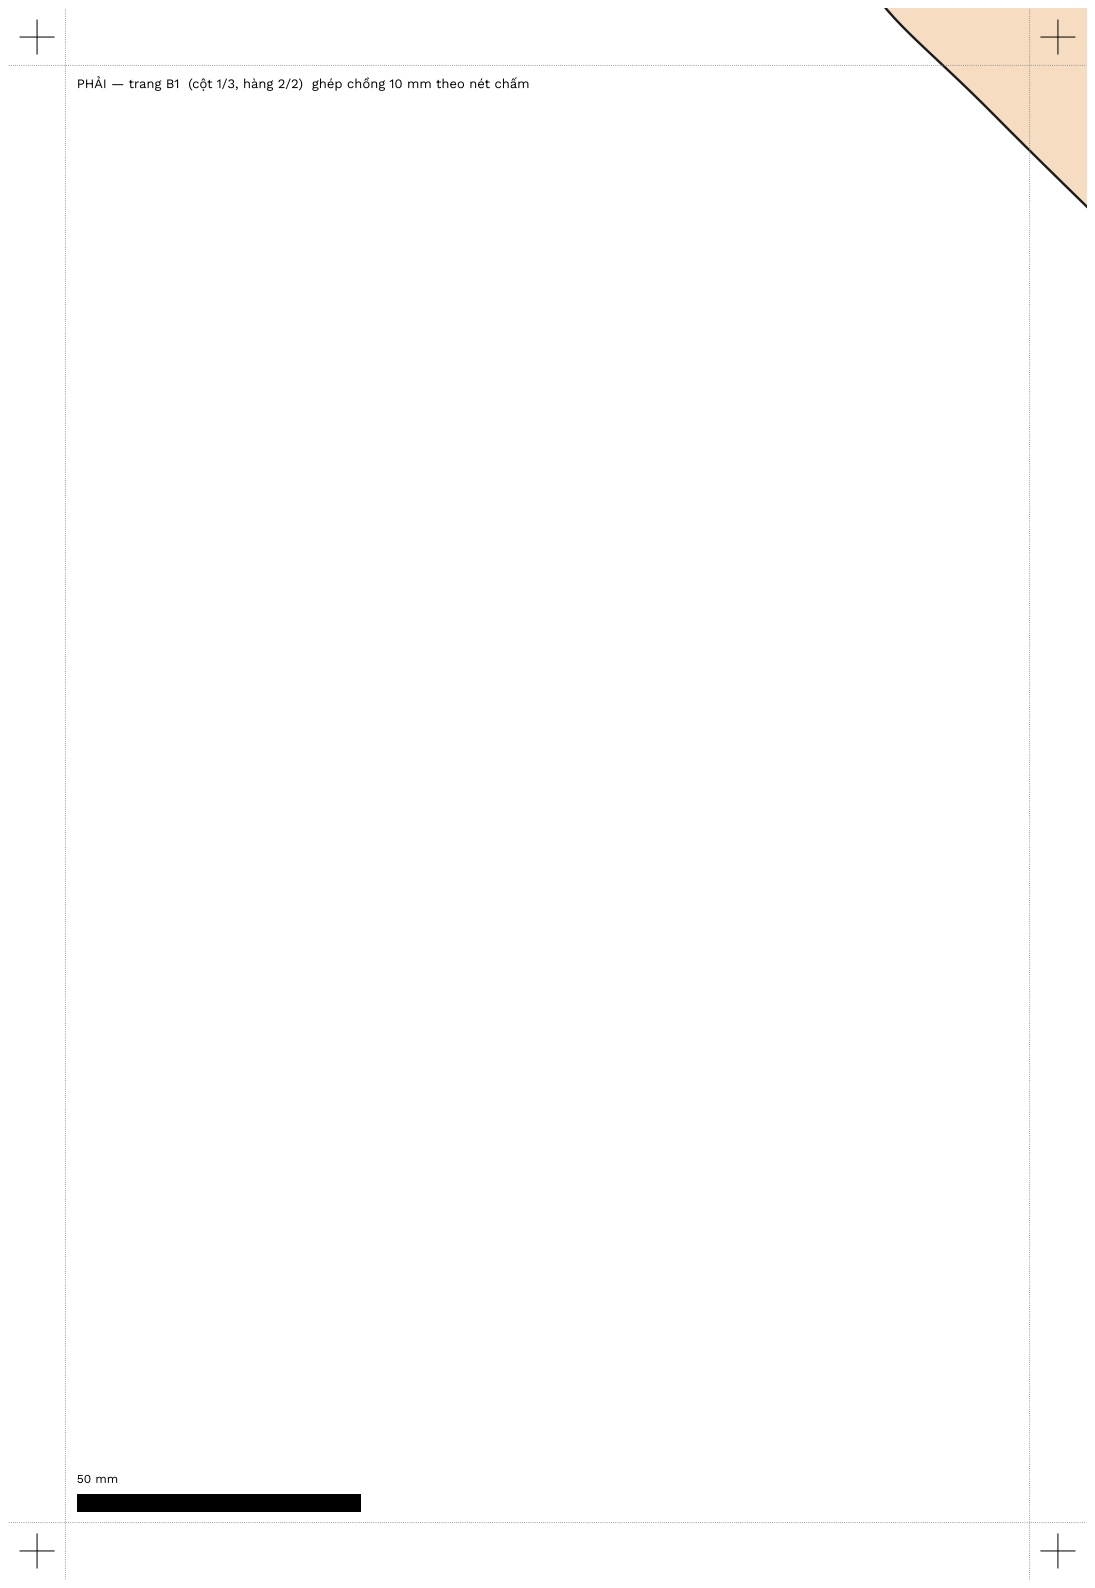
[picture p29: page 4]

PHẢI — trang B1 (cột 1/3, hàng 2/2) ghép chồng 10 mm theo nét chấm

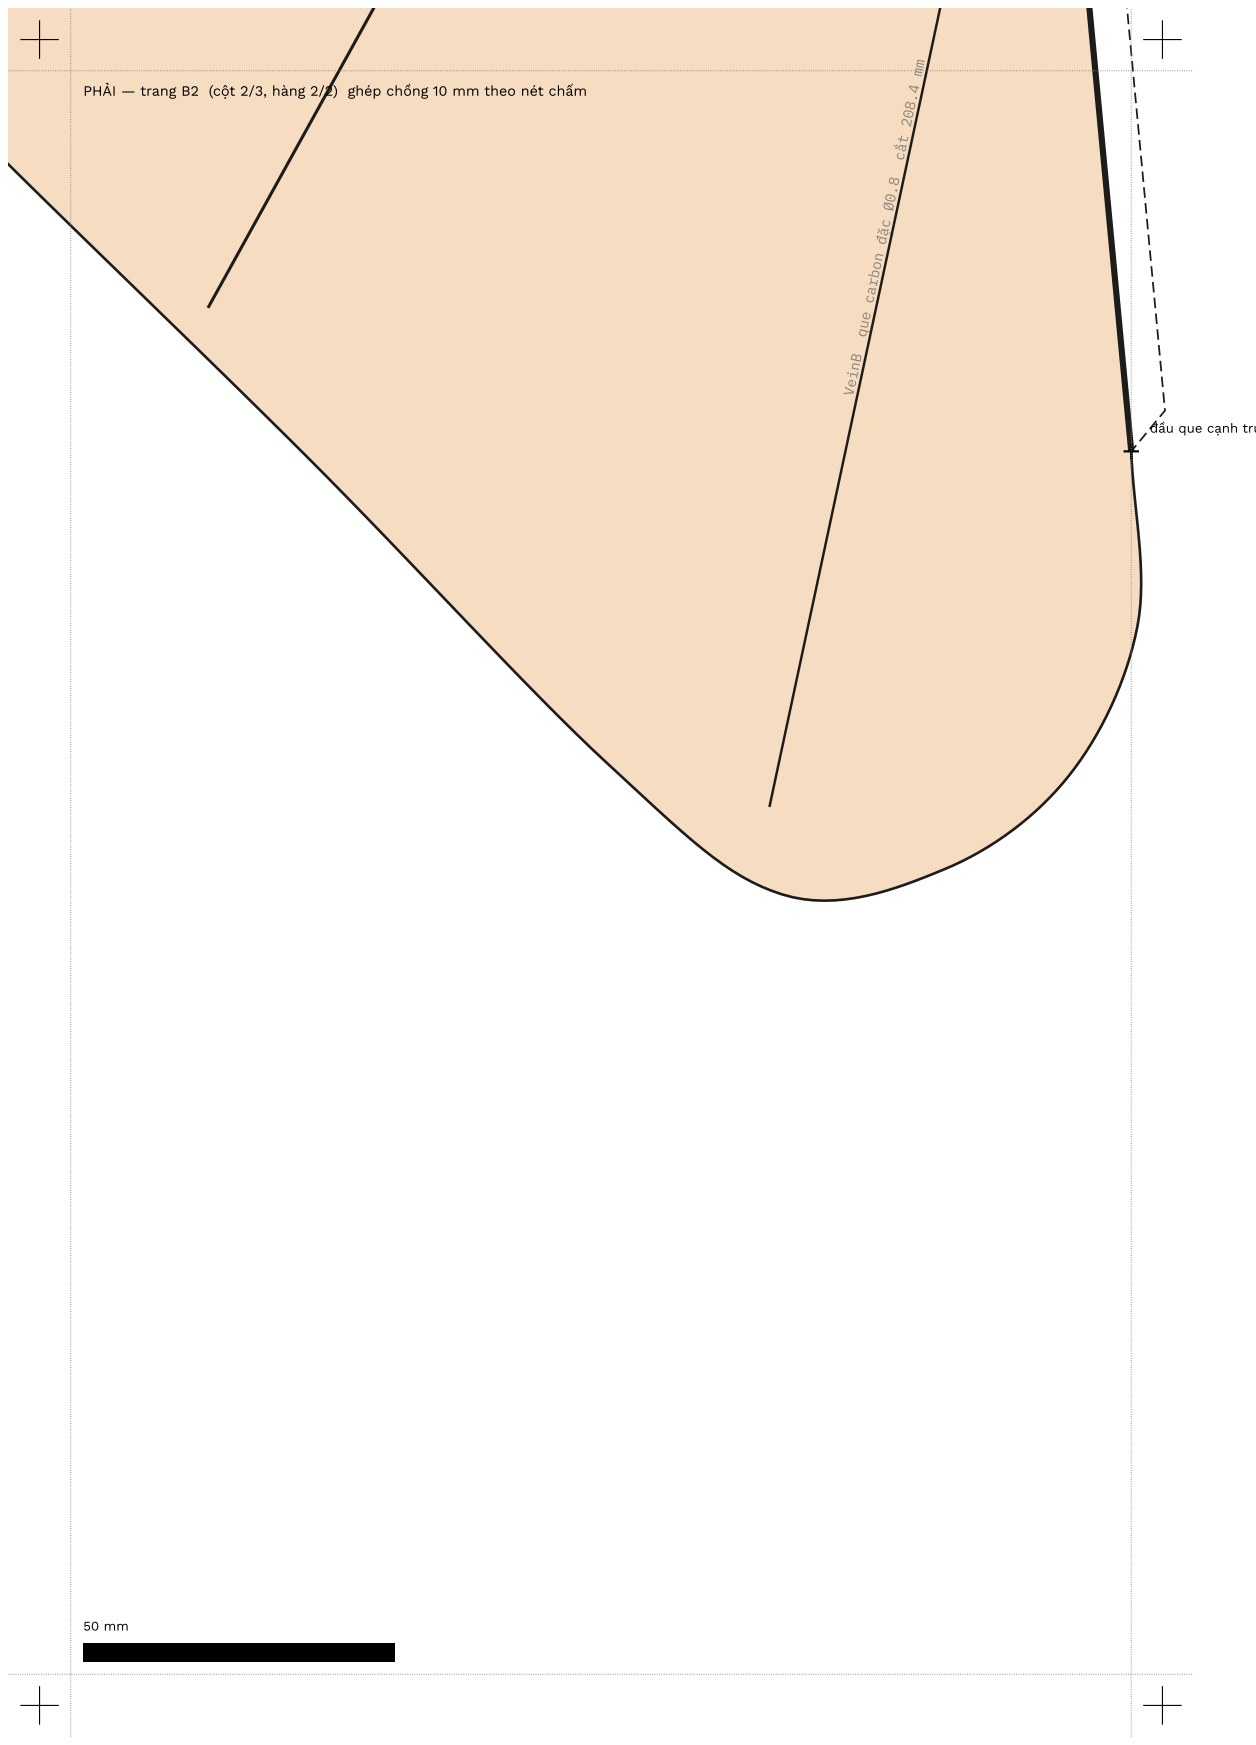
[picture p30: page 5]

đặc Ø0.8 cắt 208.4 mm

PHẢI — trang B2 (cột 2/3, hàng 2/2) ghép chồng 10 mm theo nét chấm

VeinB que carbon

đầu que cạnh trước

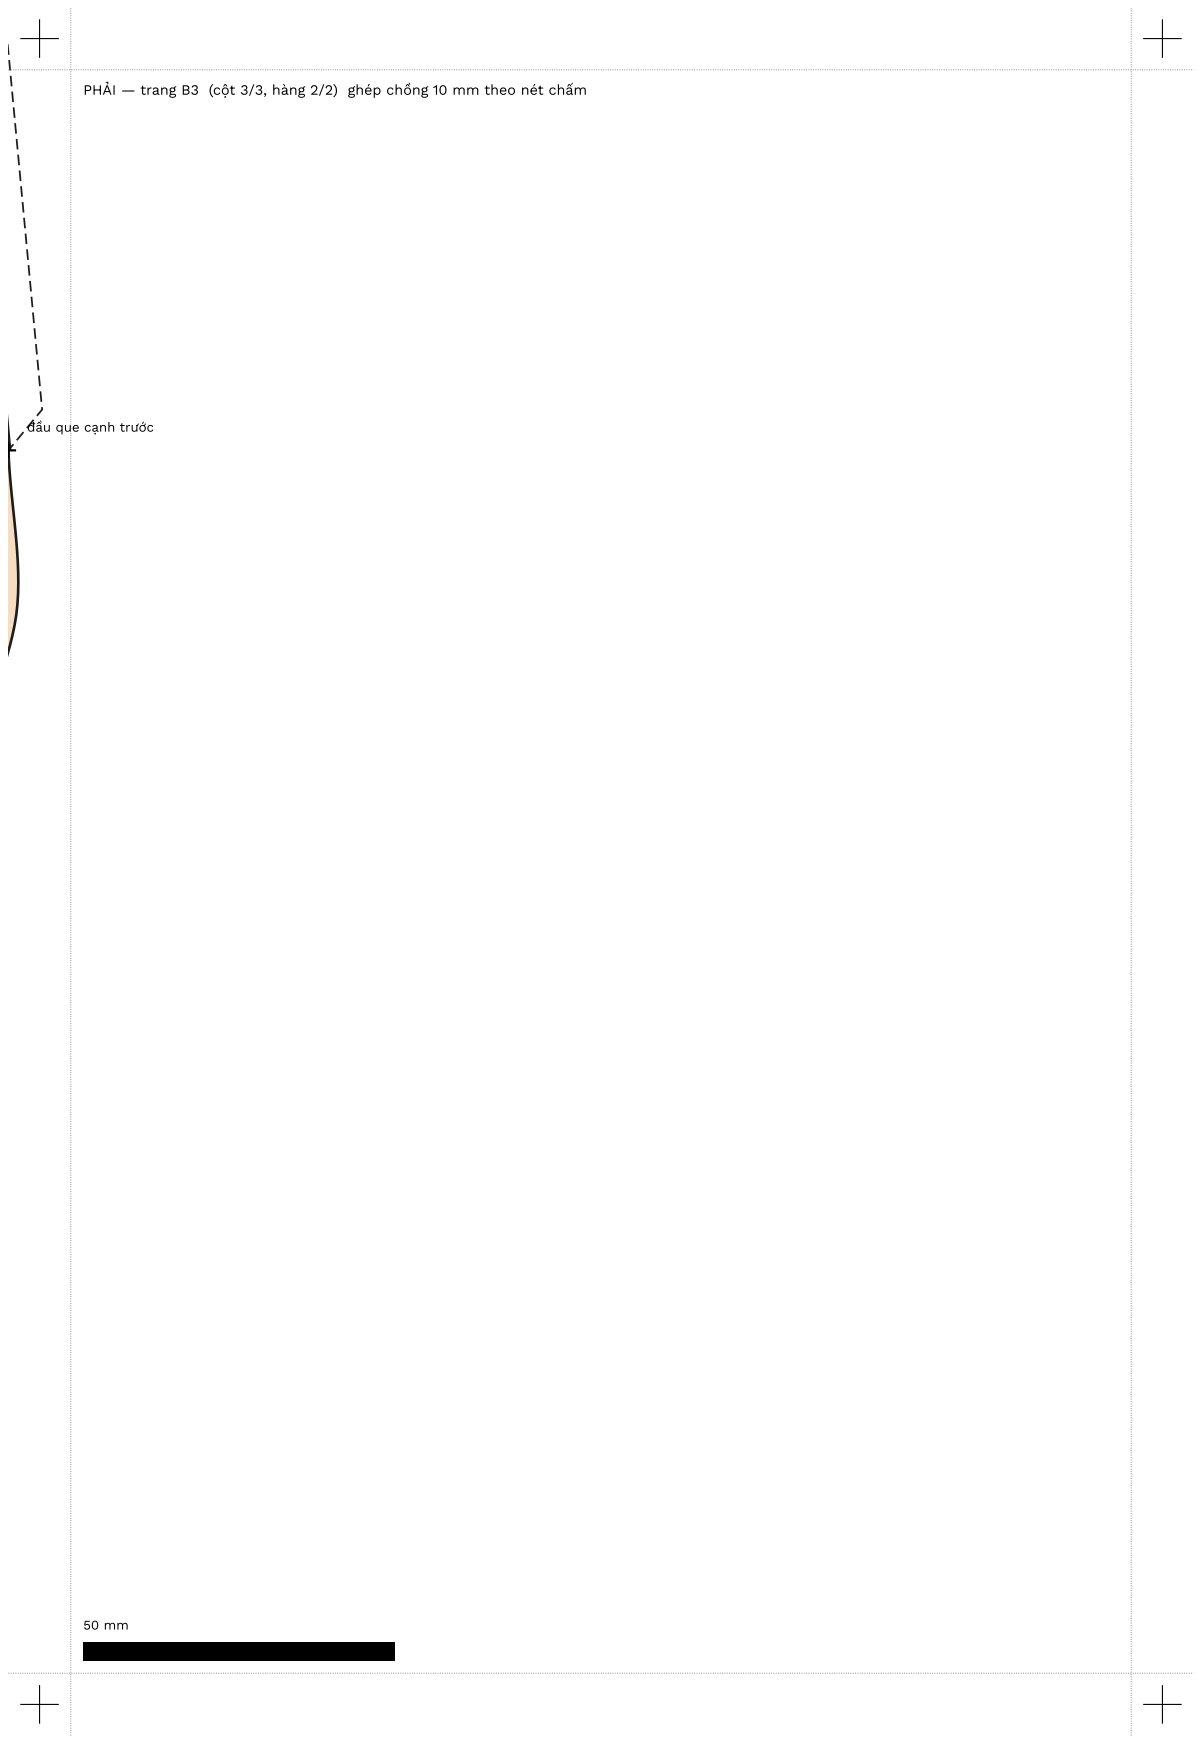
[picture p31: page 6]

PHẢI — trang B3 (cột 3/3, hàng 2/2) ghép chồng 10 mm theo nét chấm

đầu que cạnh trước

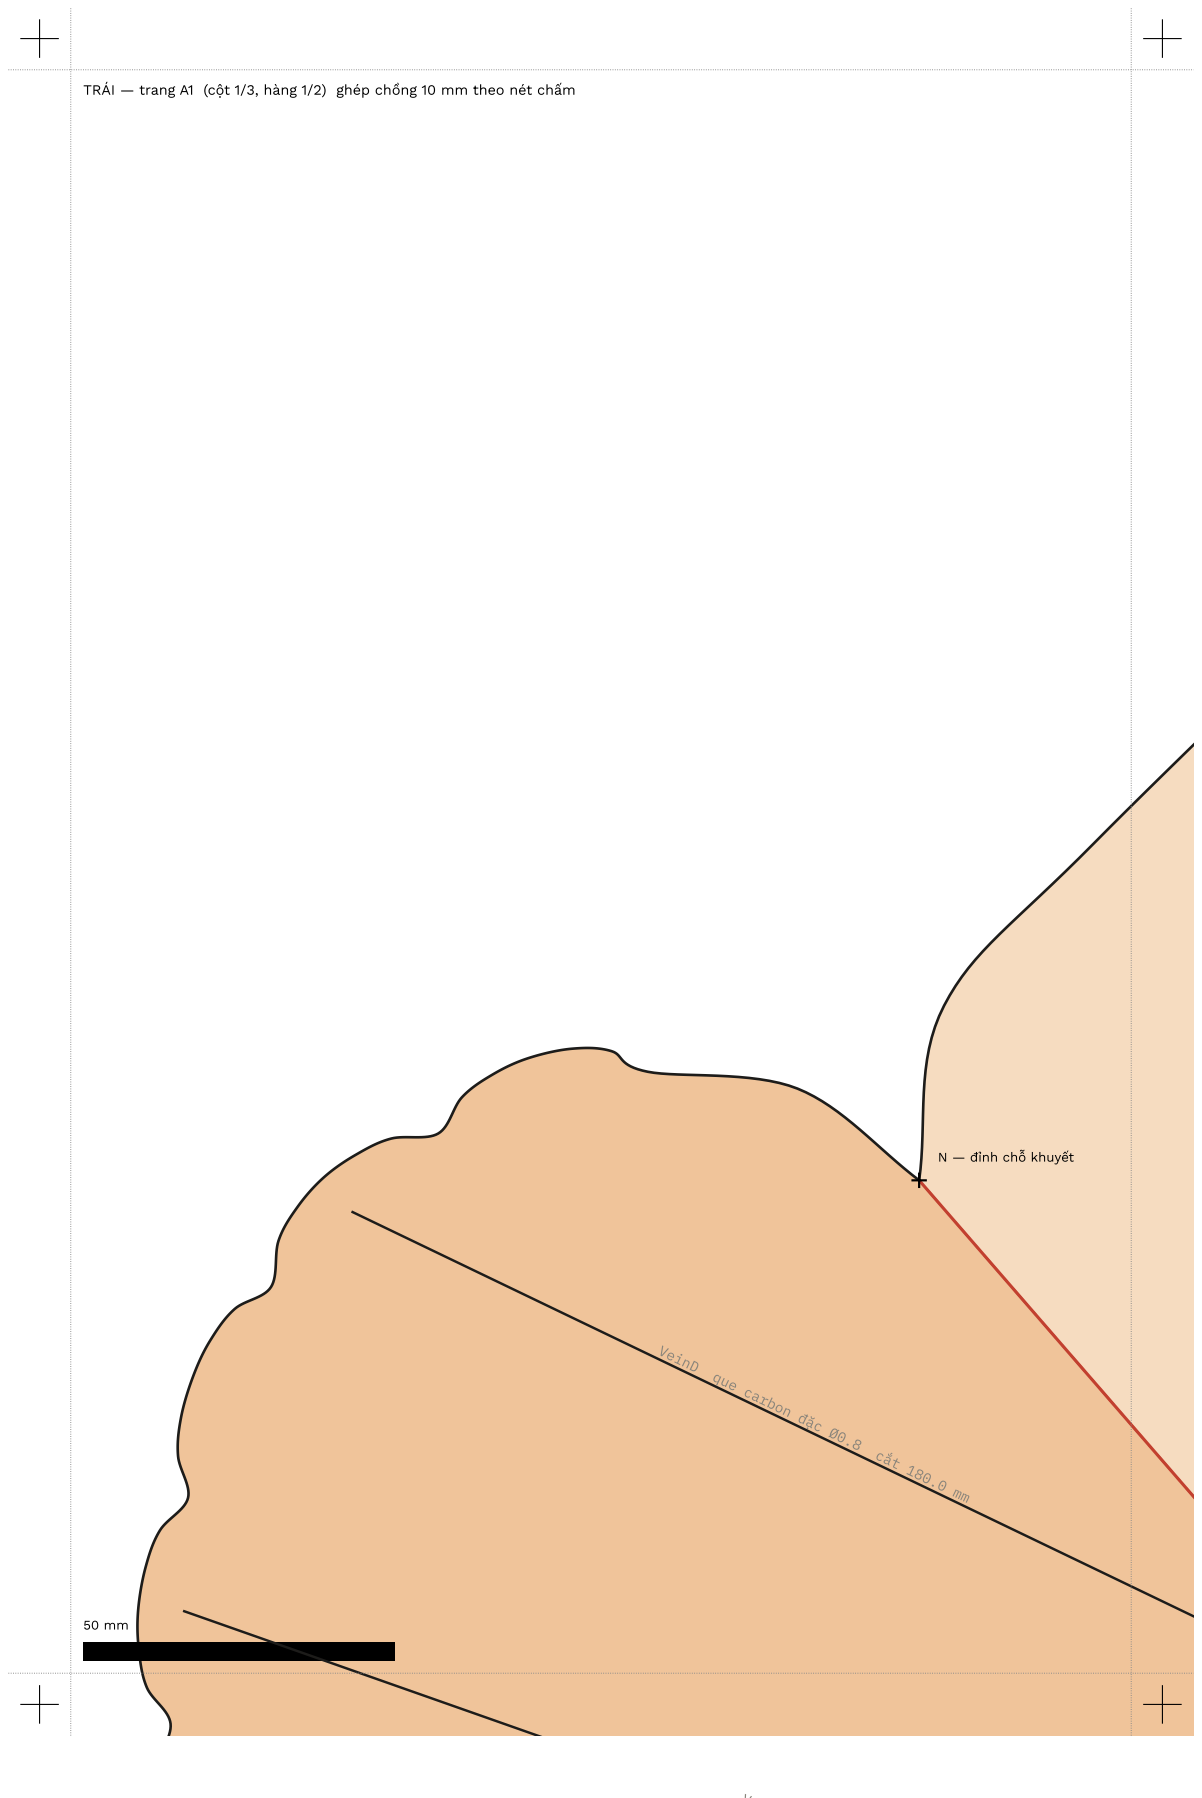
[picture p32: page 7]

TRÁI — trang A1 (cột 1/3, hàng 1/2) ghép chồng 10 mm theo nét chấm

N — đỉnh chỗ khuyết

VeinD que carbon đặc Ø0.8 cắt 180.0 mm

VeinC que carbon đặc Ø0.8 cắt 270.0 mm

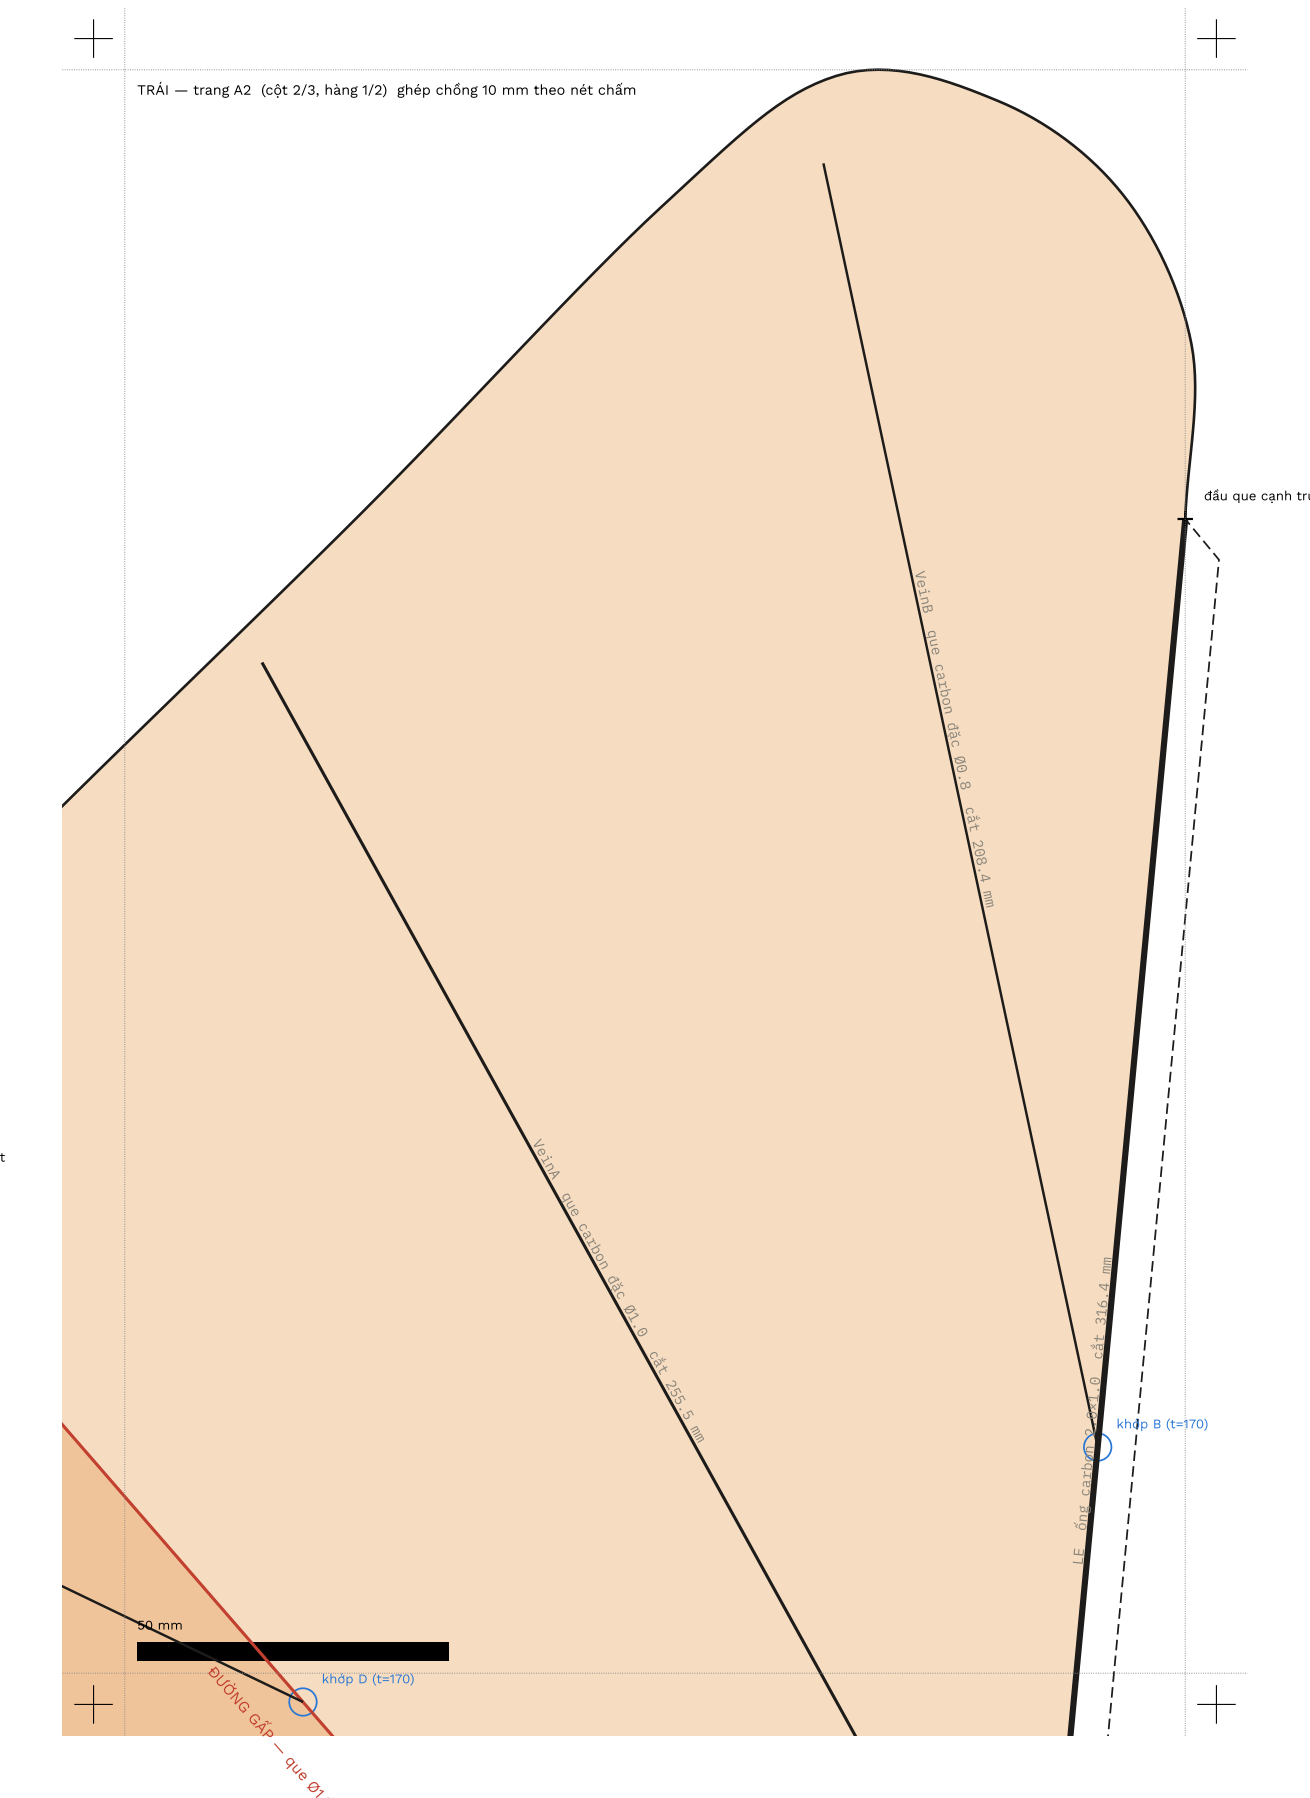
[picture p33: page 8]
ĐƯỜNG GẤP; khớp B (t=170); khớp D (t=170)

TRÁI — trang A2 (cột 2/3, hàng 1/2) ghép chồng 10 mm theo nét chấm

đầu que cạnh trước

VeinB que carbon

đặc Ø0.8 cắt 208.4 mm

N — đỉnh chỗ khuyết

VeinA que carbon

LE ống carbon 2.0×1.0 cắt 316.4 mm

đặc Ø1.0 cắt 255.5 mm

— que Ø1.0 dán dọc; gập phần sau xuống 6.6°

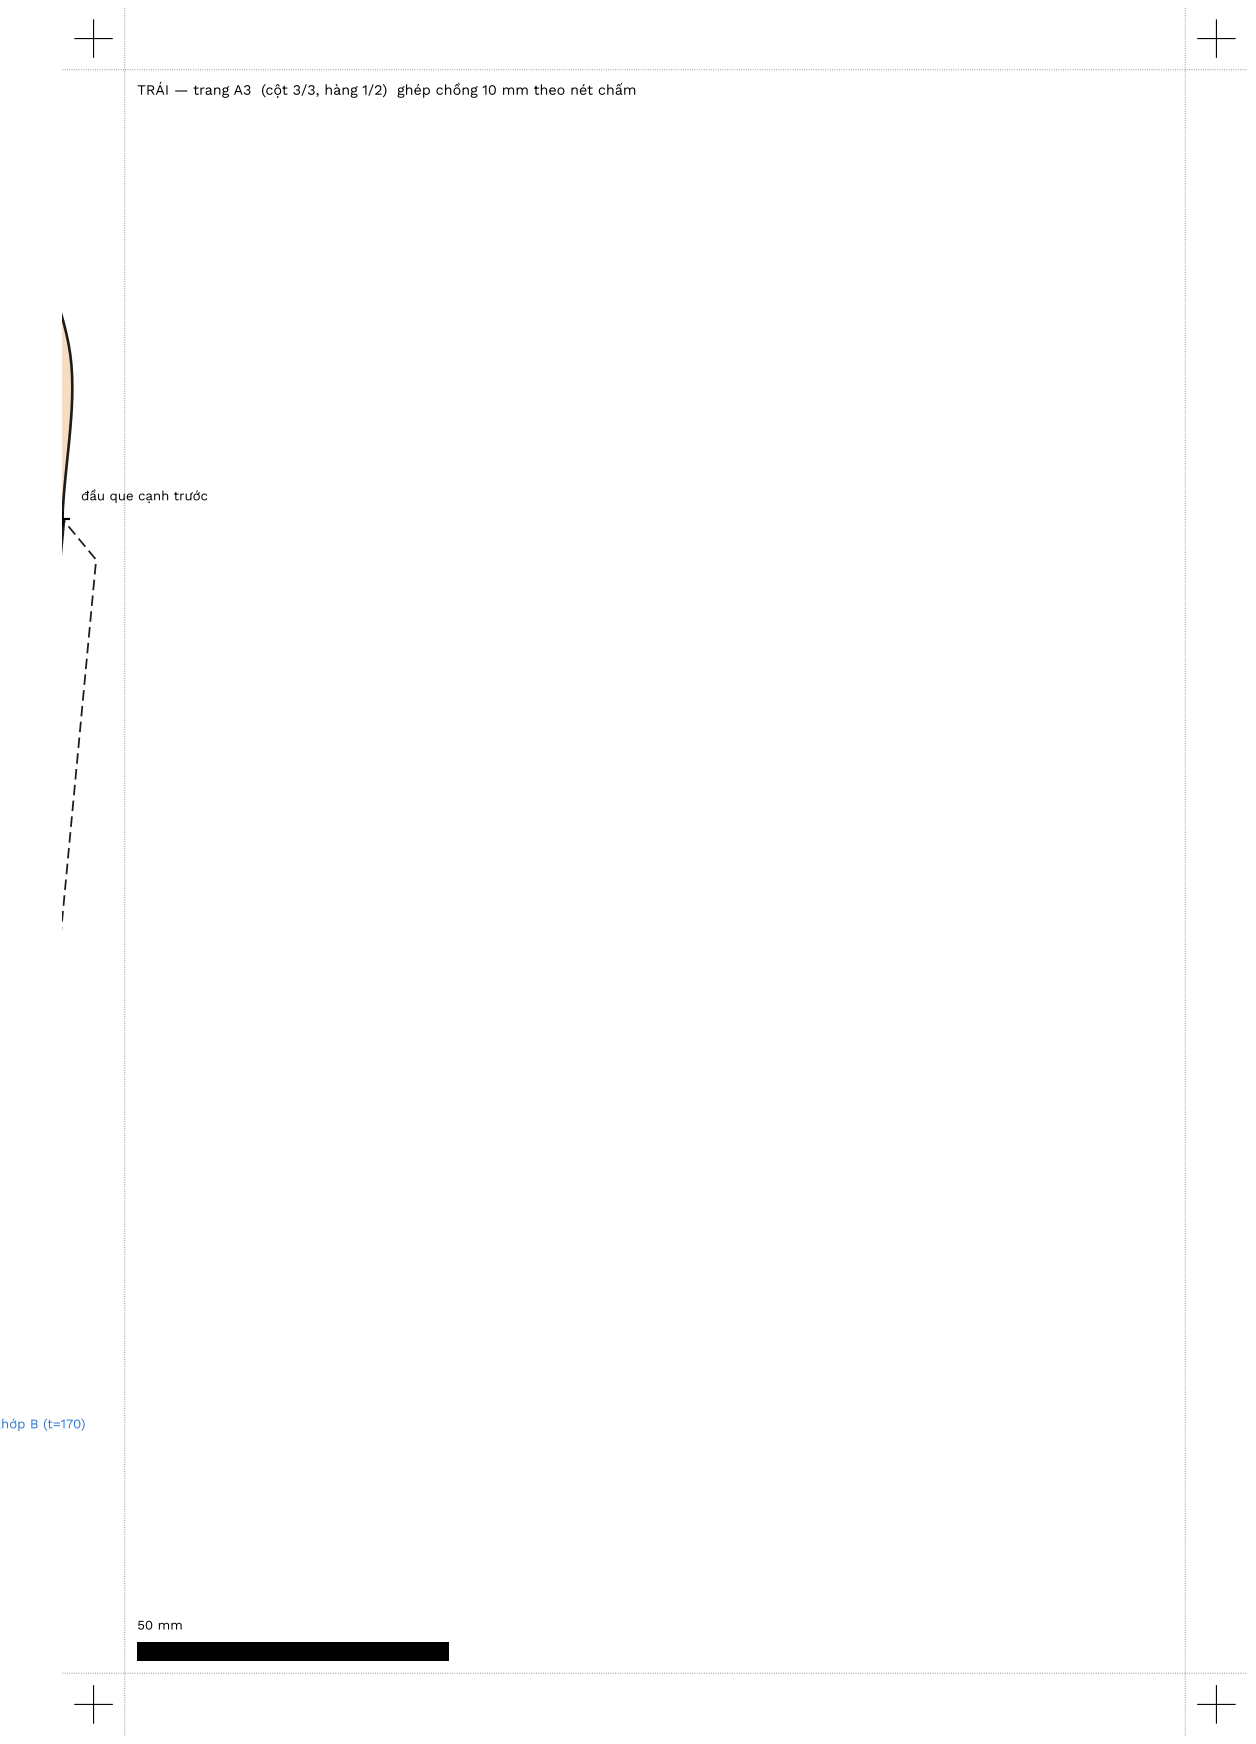
[picture p34: page 9]
khớp B (t=170)

TRÁI — trang A3 (cột 3/3, hàng 1/2) ghép chồng 10 mm theo nét chấm

đầu que cạnh trước

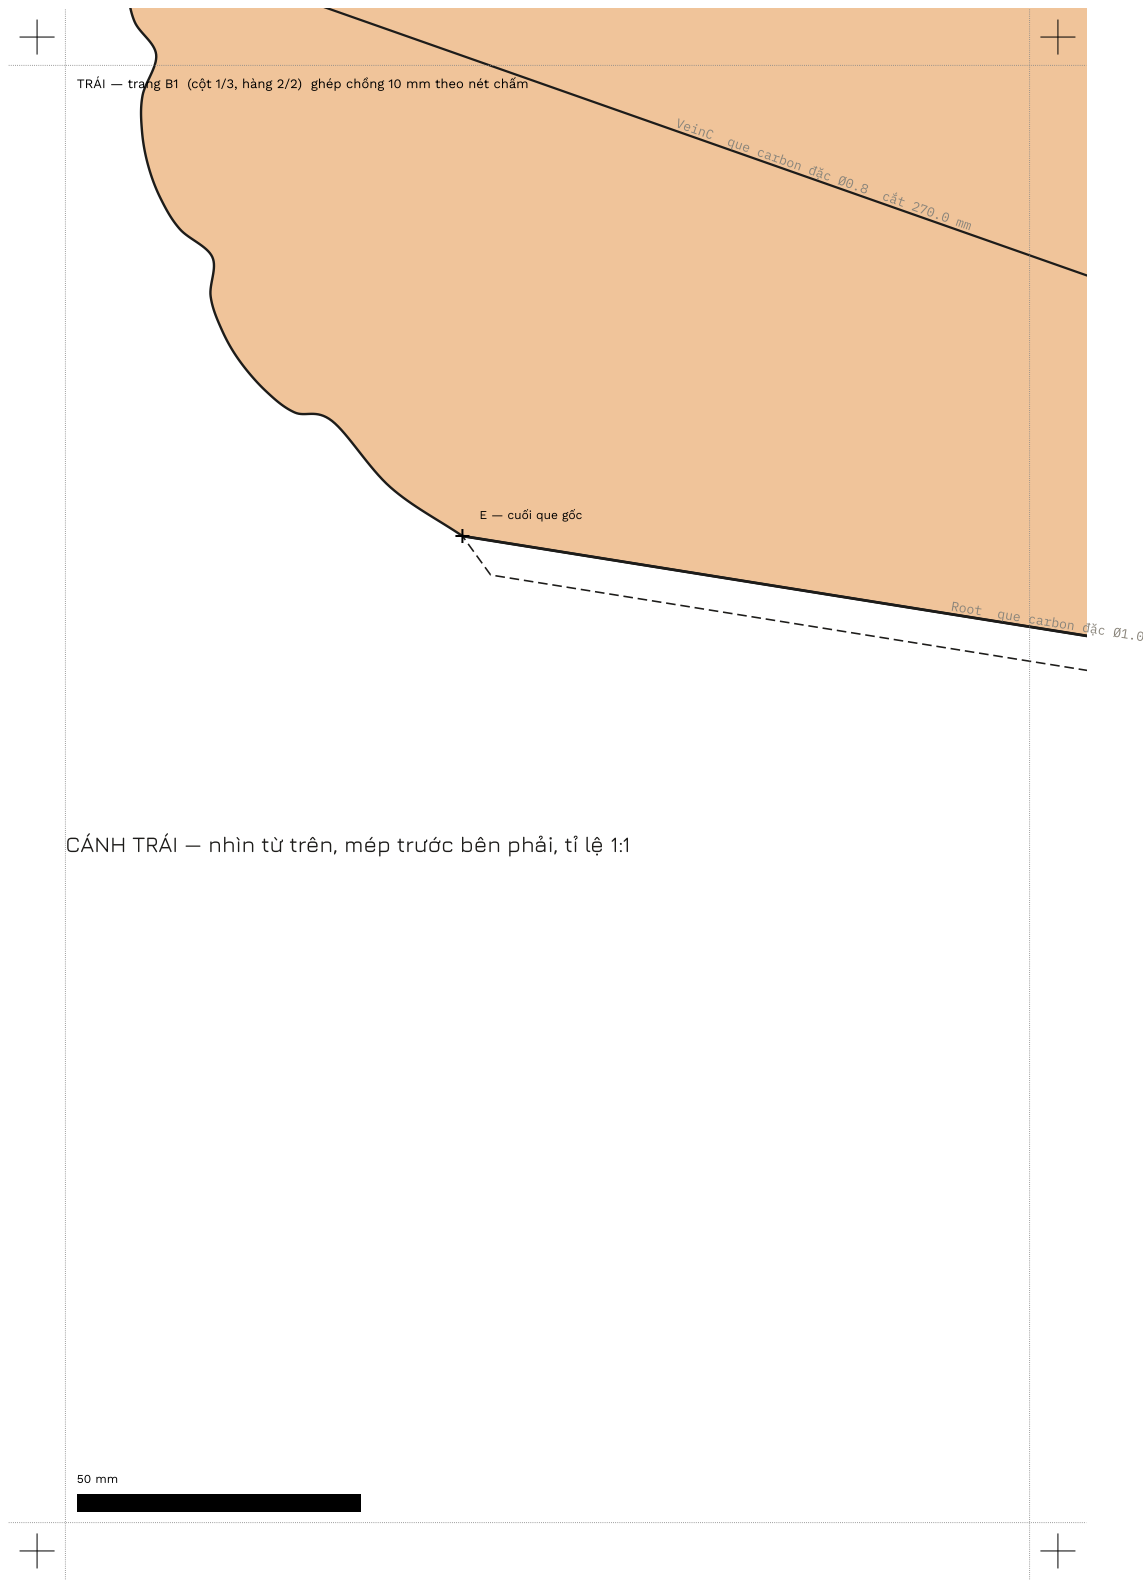
[picture p35: page 10]

TRÁI — trang B1 (cột 1/3, hàng 2/2) ghép chồng 10 mm theo nét chấm

VeinC que carbon đặc Ø0.8 cắt 270.0 mm

E — cuối que gốc

Root que carbon đặc Ø1.0 cắt 250.2 mm

CÁNH TRÁI — nhìn từ trên, mép trước bên phải, tỉ lệ 1:1

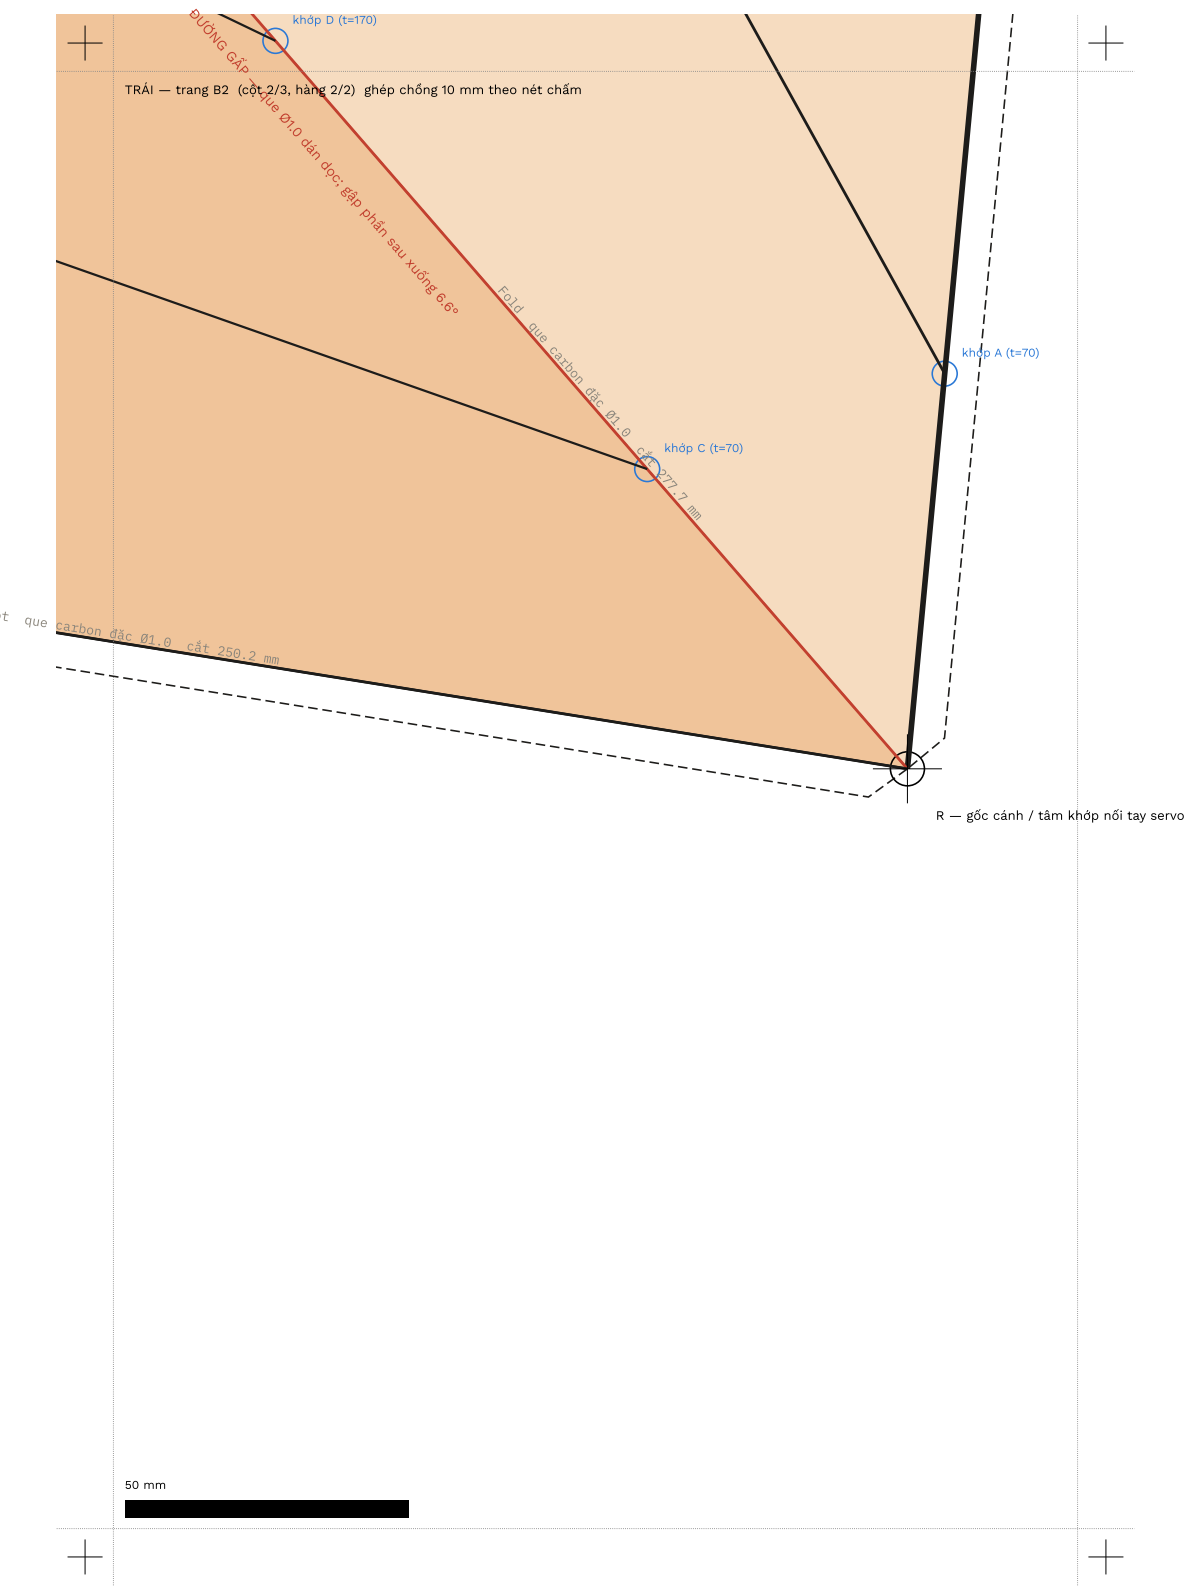
[picture p36: page 11]
ĐƯỜNG GẤP; khớp A (t=70); khớp C (t=70); khớp D (t=170)

— que Ø1.0 dán dọc; gập phần sau xuống 6.6°

TRÁI — trang B2 (cột 2/3, hàng 2/2) ghép chồng 10 mm theo nét chấm

Fold que carbon đặc Ø1.0 cắt 277.7 mm

Root que carbon đặc Ø1.0 cắt 250.2 mm

R — gốc cánh / tâm khớp nối tay servo

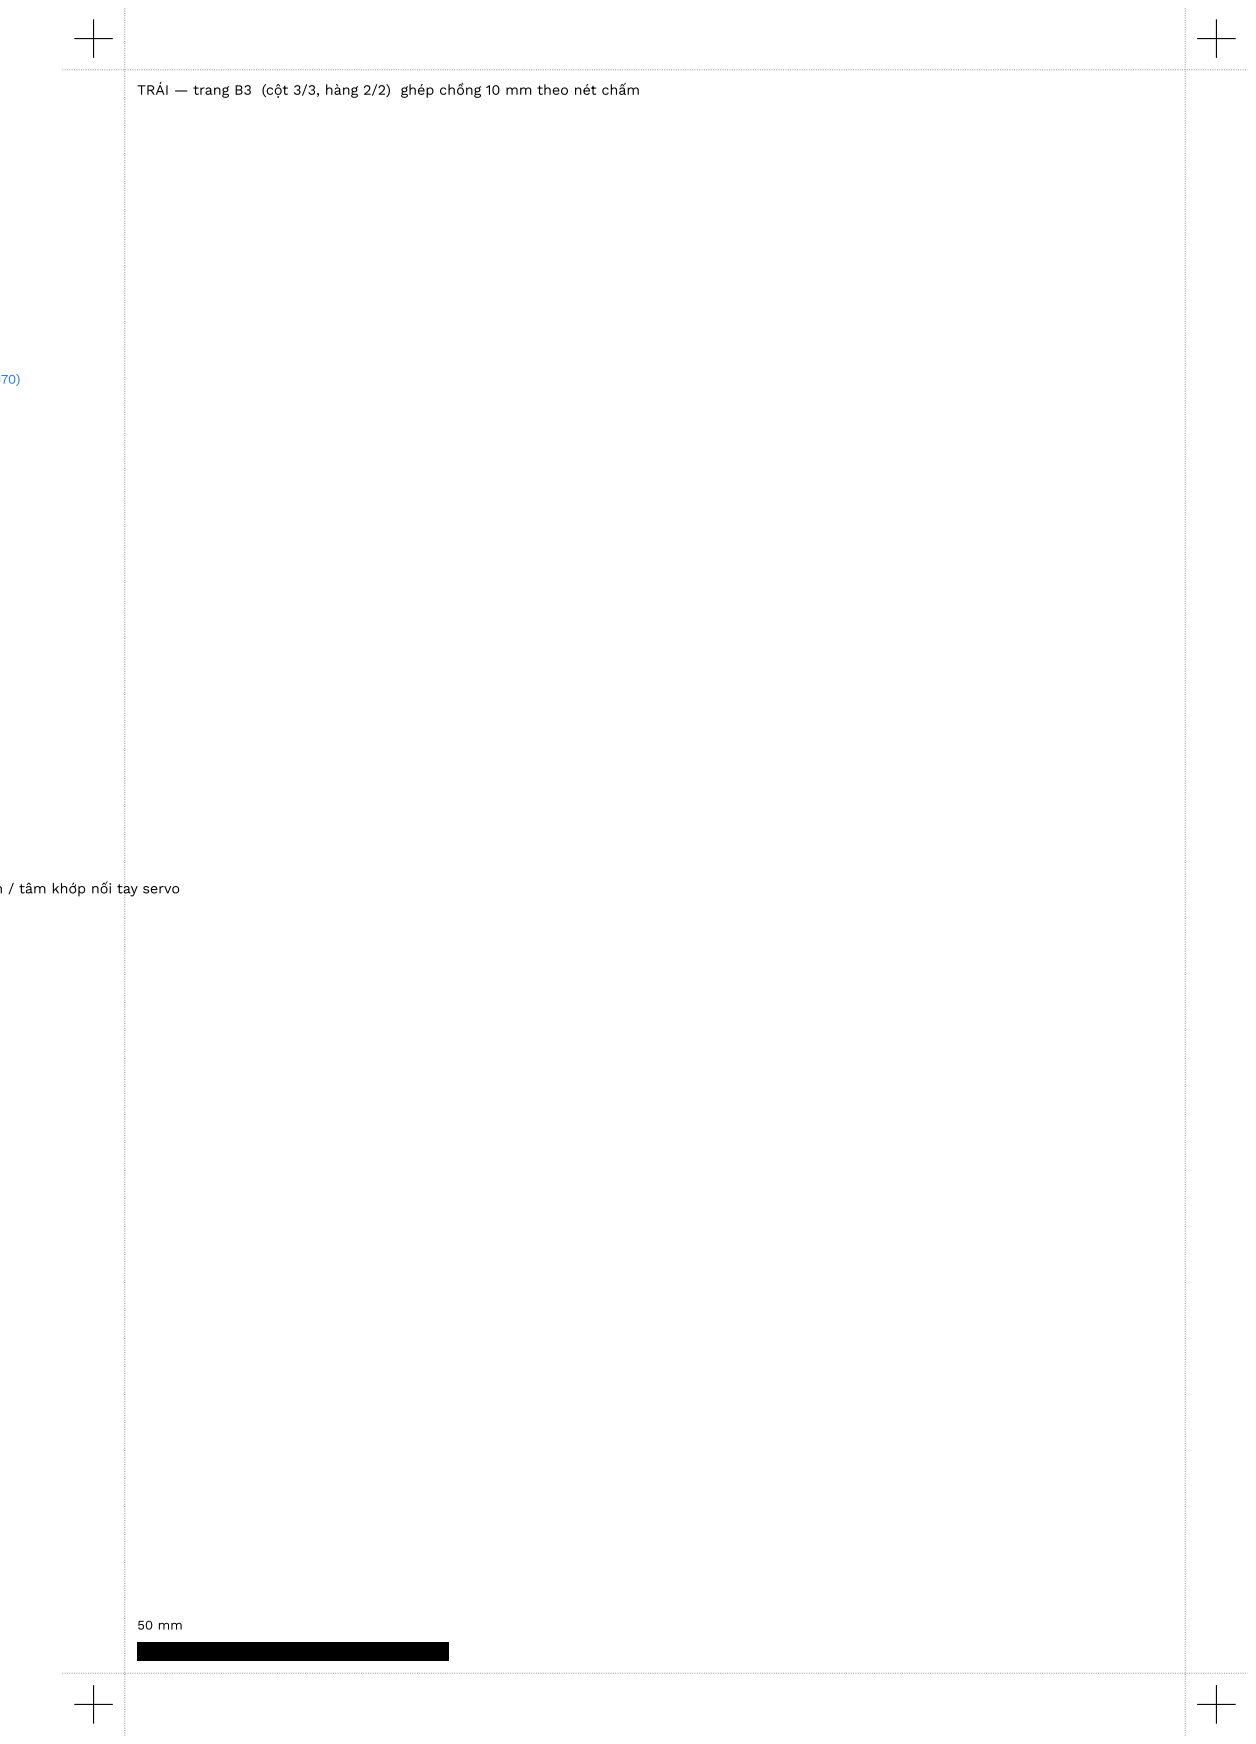
[picture p37: page 12]
khớp A (t=70)

TRÁI — trang B3 (cột 3/3, hàng 2/2) ghép chồng 10 mm theo nét chấm

R — gốc cánh / tâm khớp nối tay servo
