twhunq/Butterfly-RC/(commit log)

2026-10-04 Butterfly RC v3: single-sheet folded wing, CAD/simulation from one source
    - design/: butterfly_params.json + wing_geometry.py (single source of truth),
    fusion_build.py (Fusion CAD + joints + mass export), 1:1 wing templates (A2/A4),
    rod cut list, STL parts, dossier cover, construction guide
    - analysis/: quasi-steady aero/servo/rod-bending model, Ptera UVLM stability and
    6-DOF free flight (MuJoCo) driven by the Fusion mass properties; results + report
    - simulation/: flapping GIFs rendered from the Fusion model (v1, v2 archived)
    [2w_cg15_h-4_U4.0_a9.csv, 2w_cg20_h-4_U3.6_a9.csv, 2w_cg20_h-6_U3.4_a12.csv, Frame_ServoMount.stl, PRINT_ConnA_L.stl, PRINT_ConnA_R.stl, PRINT_ConnB_L.stl, PRINT_ConnB_R.stl]
2026-10-05 Solid one-piece wing hub and stronger printed parts
    - Replace the horn adapter (thin 0.9 mm socket walls, ~25 MPa at the socket root)
    with PRINT_WingHub: clamp block (2 mm walls, 2x M2 through), core sphere,
    tapered sockets (LE 7.2->4.6 mm, fold/root 4.6->3.2 mm) and webs; 1.72 g each
    - Vein connectors 1.0/1.2 mm walls with filleted T-joint; frame walls 1.6 mm
    - All printed bodies verified single-lump; no collisions at 0/±36/±45 deg
    - analysis/printed_parts_check.py: socket stresses 3.5-5.0 MPa, fatigue SF >= 1.6
    - Battery moved to x=-73.5 mm to keep CG at 20.0 mm (mass 63.8 g);
    stability and ±20 deg free flight re-run: still stable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
    [Frame_ServoMount.stl, PRINT_ConnA_L.stl, PRINT_ConnA_R.stl, PRINT_ConnB_L.stl, PRINT_ConnB_R.stl, PRINT_ConnC_L.stl, PRINT_ConnC_R.stl, PRINT_HornAdapter_L.stl]
2026-10-05 Fix servo-ear clash: lower spine below the mounting ears
    - Servo ears (4.5 mm below the servo bottom) cut into the spine sleeve and spine.
    Spine/sleeves now sit at z=-7.7 mm (0.8 mm under the ears); the frame reaches
    the sleeve through a web under the band only; tray plate and battery follow.
    - fusion_build.py checks every body pair for interference and records it in
    fusion_mass_properties.json ("static_clashes": none).
    - Battery x=-75.2 mm keeps CG at 20.0 mm (64.2 g); static margin 17.5 mm.
    [Frame_ServoMount.stl, Tray_Abdomen.stl]
